sarietta/theoputer-blog/static/img/the-first-operation/4x/step1@4x.png

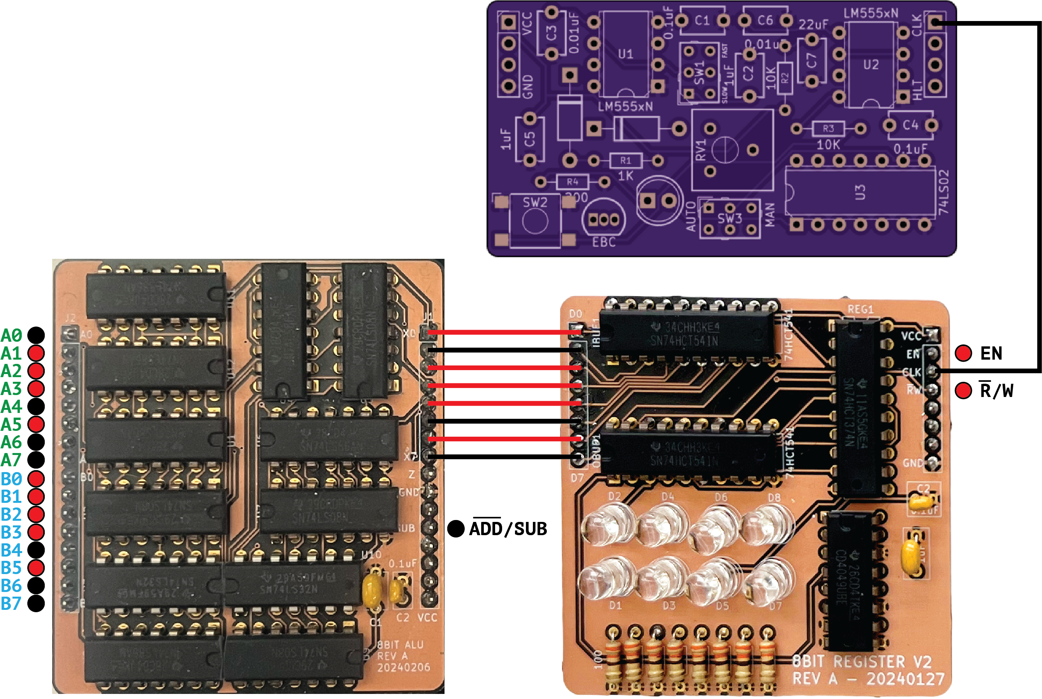
static/img/the-first-operation/4x/step1@4x.png
