sarietta/theoputer-blog/static/img/overview/programmer.png

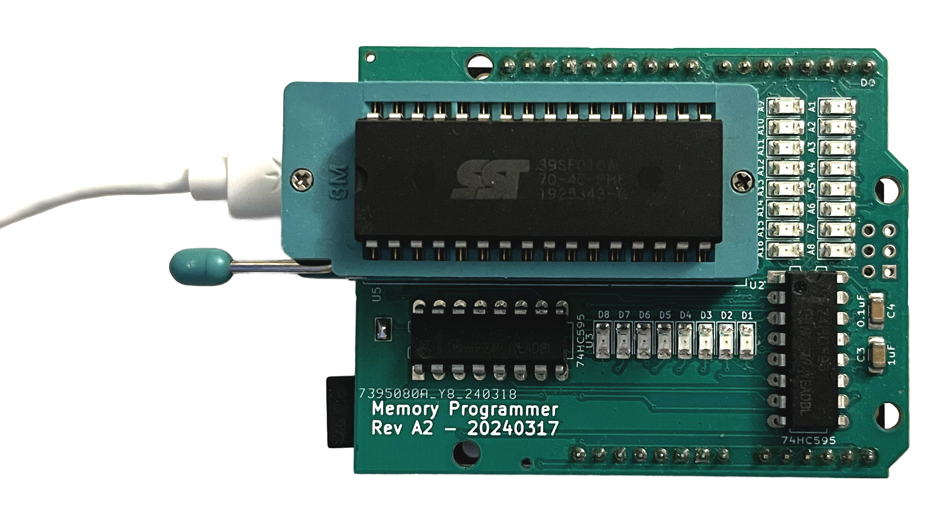
static/img/overview/programmer.png
