sarietta/theoputer-blog/static/img/1x/clock-cycle.png

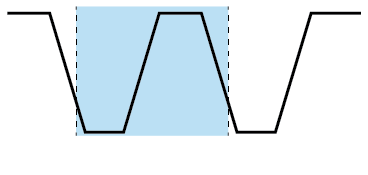
static/img/1x/clock-cycle.png
