sarietta/theoputer-blog/static/img/1x/do-irq-set.png

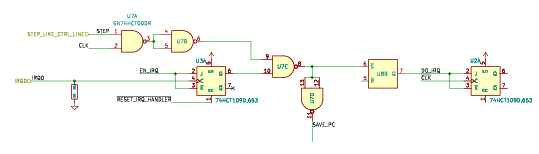
static/img/1x/do-irq-set.png
