sarietta/theoputer-blog/static/img/1x/down-clock-phase.png

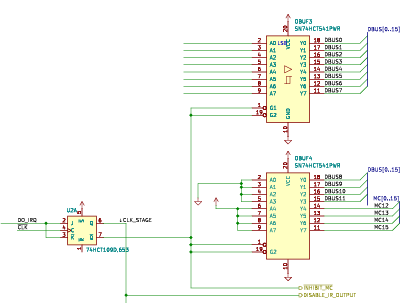
static/img/1x/down-clock-phase.png
