sarietta/theoputer-blog/static/img/1x/load-irq-address.png

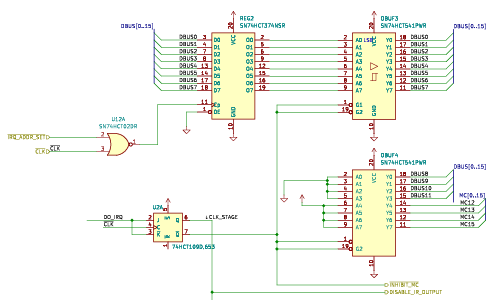
static/img/1x/load-irq-address.png
