sarietta/theoputer-blog/static/img/1x/missed-interrupts.png

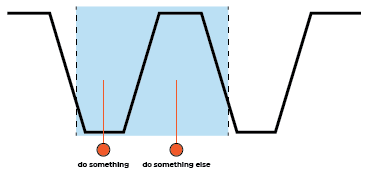
static/img/1x/missed-interrupts.png
