sarietta/theoputer-blog/static/img/1x/pc-address-return.png

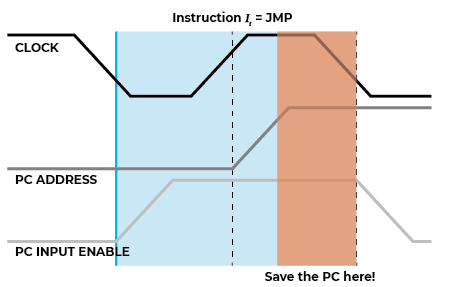
static/img/1x/pc-address-return.png
