sarietta/theoputer-blog/static/img/1x/return-to-normal-execution.png

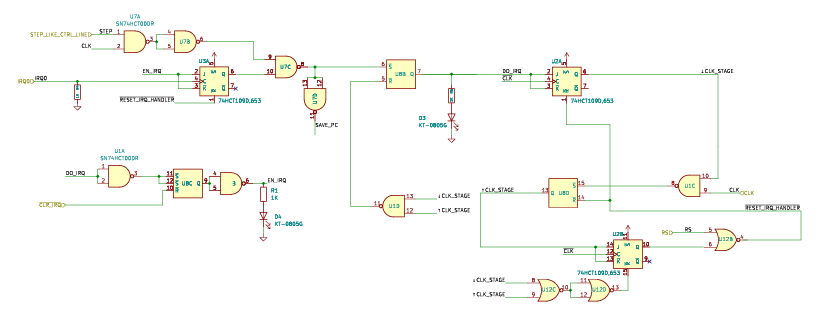
static/img/1x/return-to-normal-execution.png
