sarietta/theoputer-blog/static/img/8bit-register.png

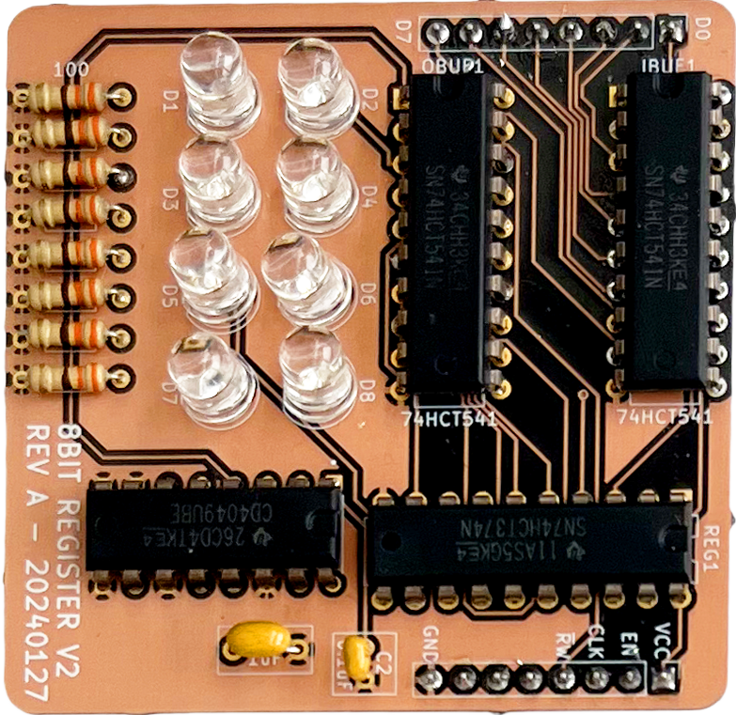
static/img/8bit-register.png
