sarietta/theoputer-blog/static/img/alu/alu-final-stage.png

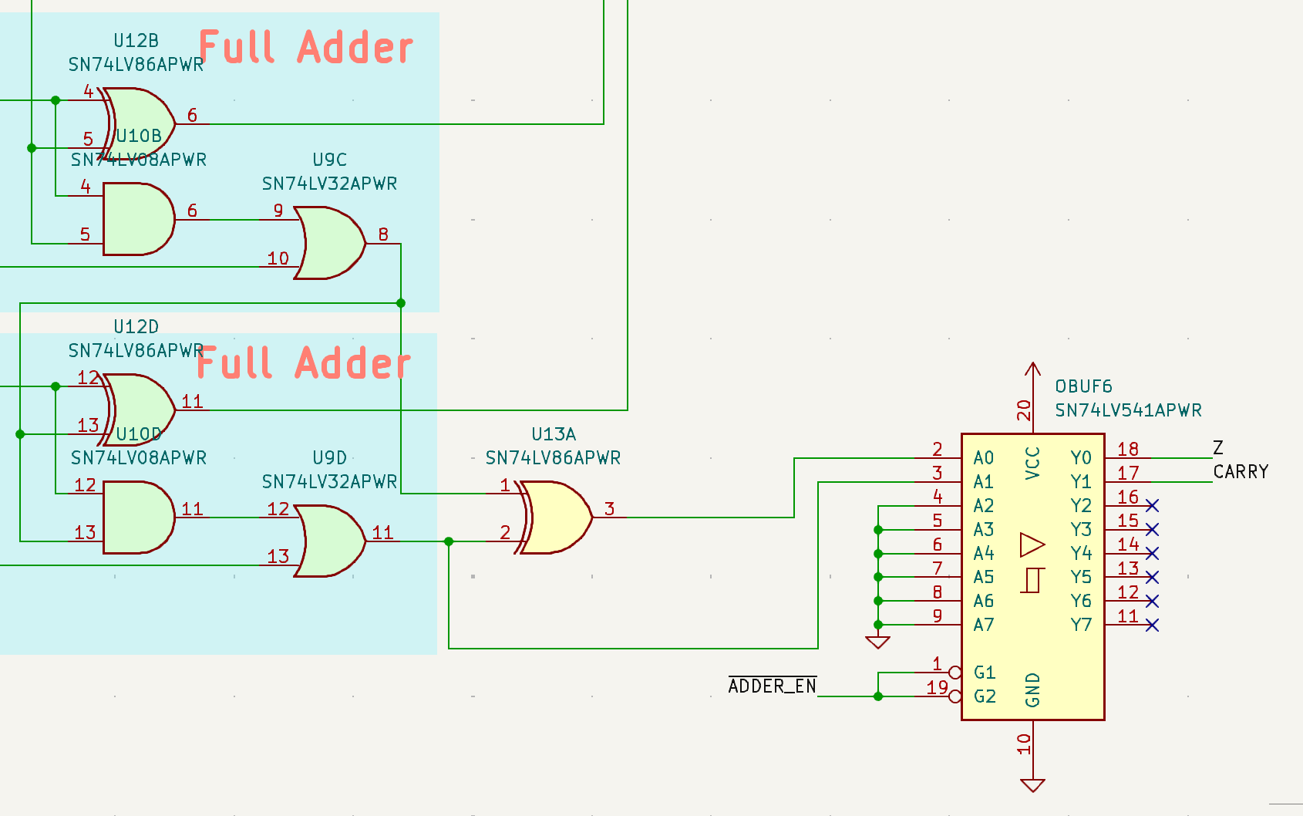
static/img/alu/alu-final-stage.png
