sarietta/theoputer-blog/static/img/alu/alu-interface.png

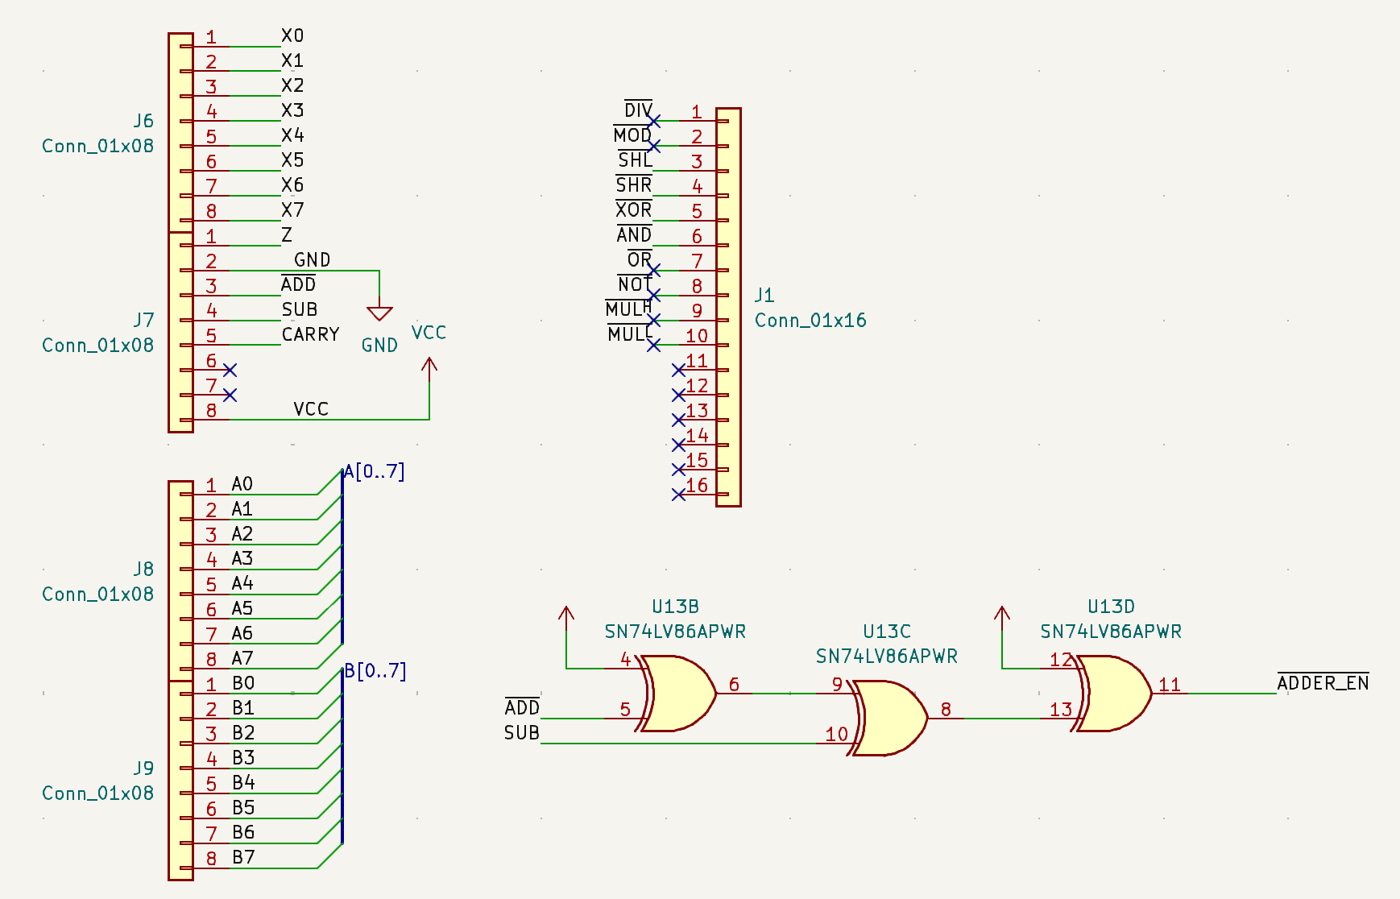
static/img/alu/alu-interface.png
