sarietta/theoputer-blog/static/img/alu/alu-subtraction.png

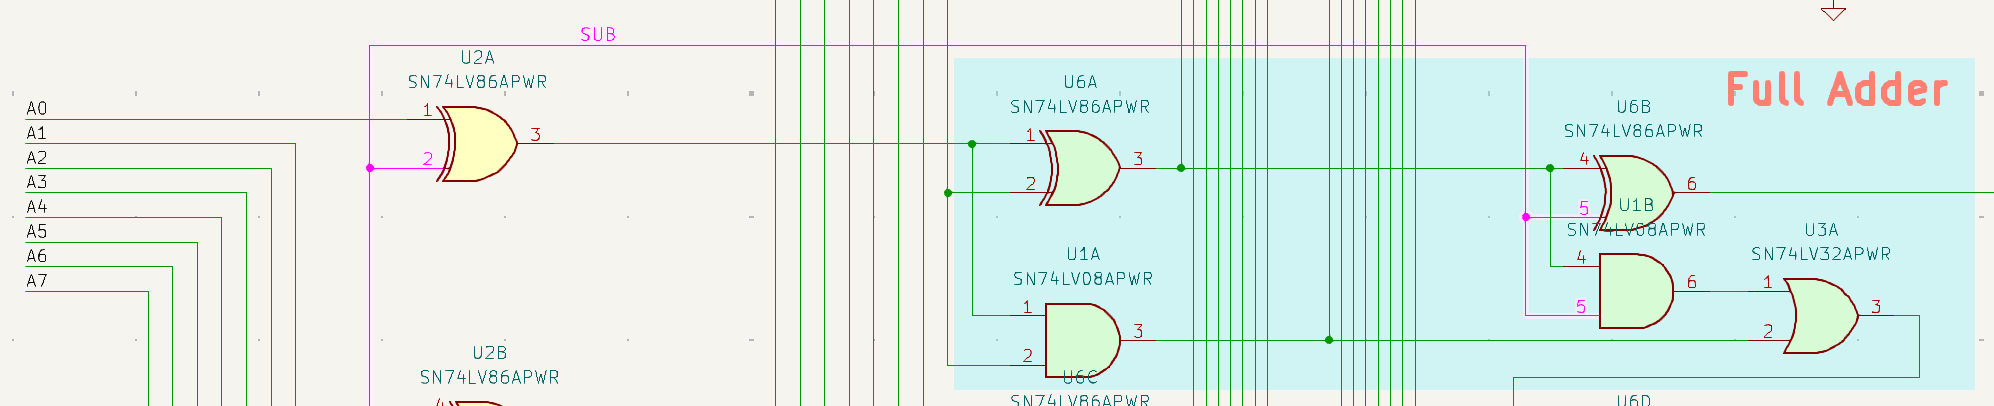
static/img/alu/alu-subtraction.png
