sarietta/theoputer-blog/static/img/c-compiler-intro/4x/parsed@4x.png

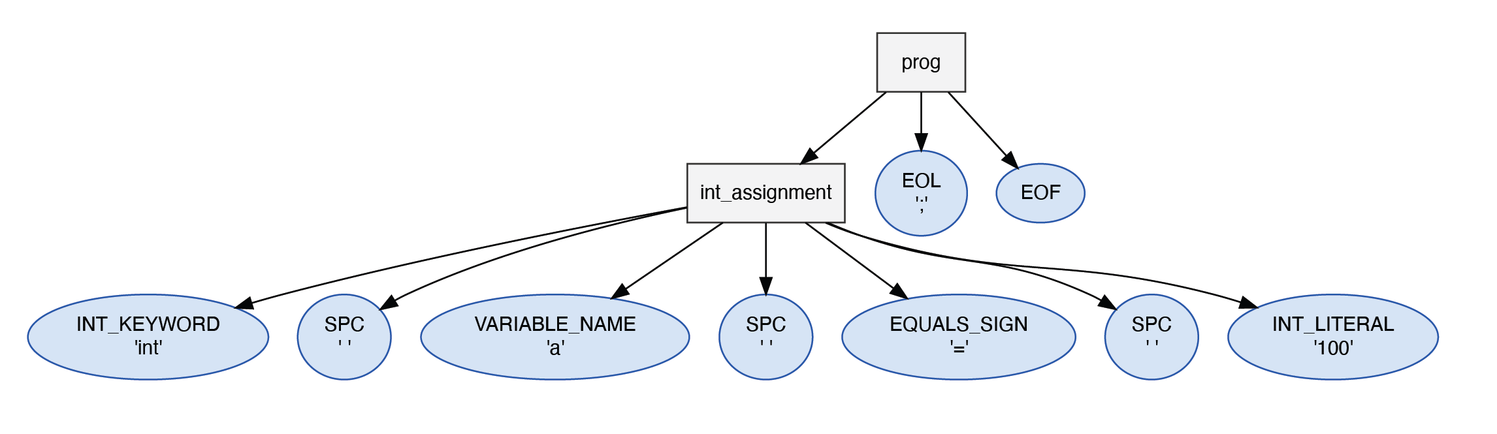
static/img/c-compiler-intro/4x/parsed@4x.png
