sarietta/theoputer-blog/static/img/CD74HCT161-delays.png

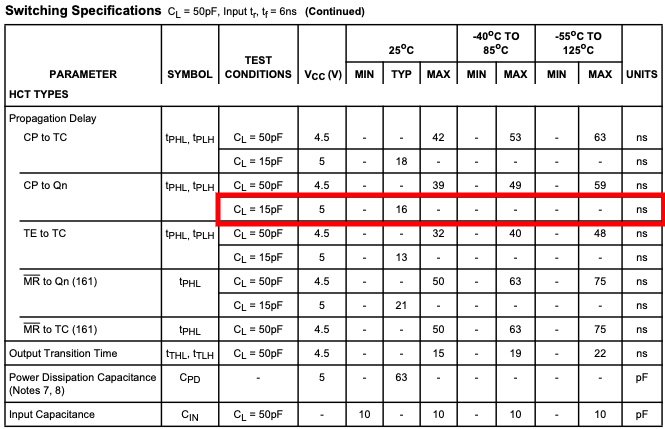
static/img/CD74HCT161-delays.png
