sarietta/theoputer-blog/static/img/clock-cycle.png

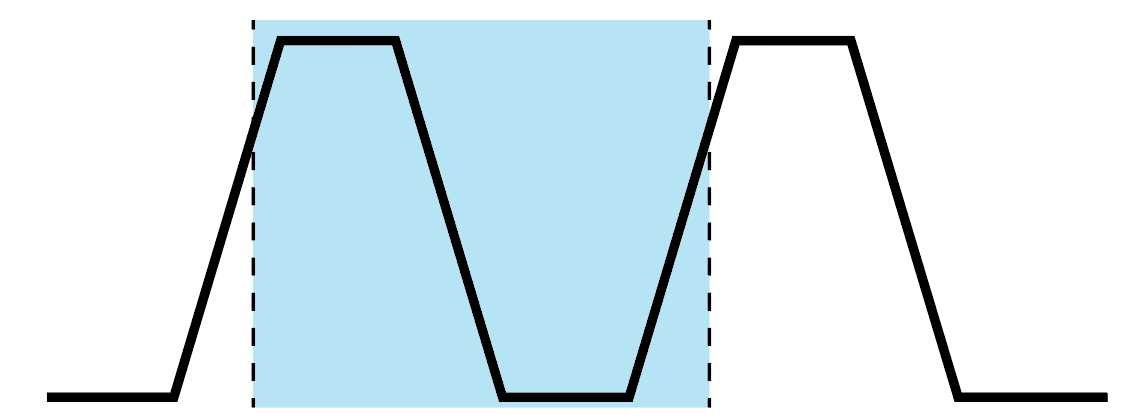
static/img/clock-cycle.png
