sarietta/theoputer-blog/static/img/clock-extras/debounce_bouncing.png

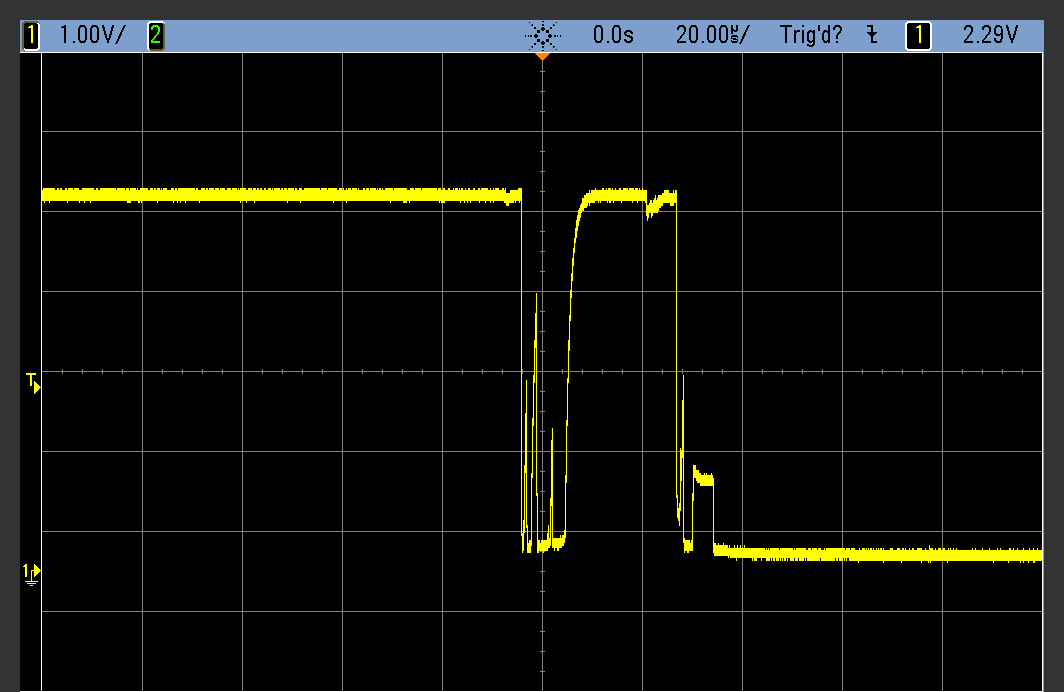
static/img/clock-extras/debounce_bouncing.png
