sarietta/theoputer-blog/static/img/clock-extras/monostable-multivibrator.png

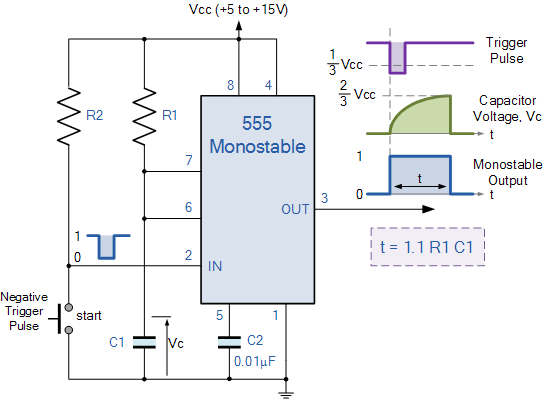
static/img/clock-extras/monostable-multivibrator.png
