sarietta/theoputer-blog/static/img/clock/2x/fetch-execute@2x.png

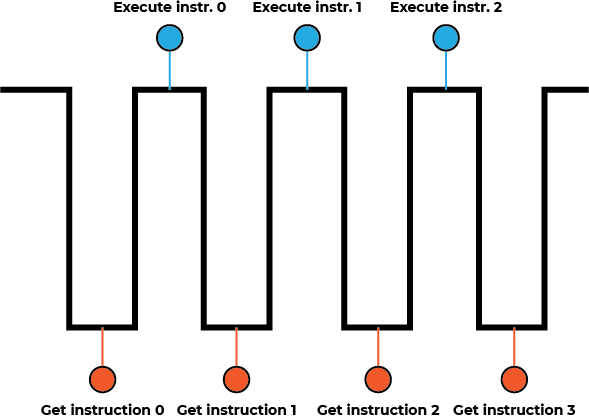
static/img/clock/2x/fetch-execute@2x.png
