sarietta/theoputer-blog/static/img/clock/2x/real-clock@2x.png

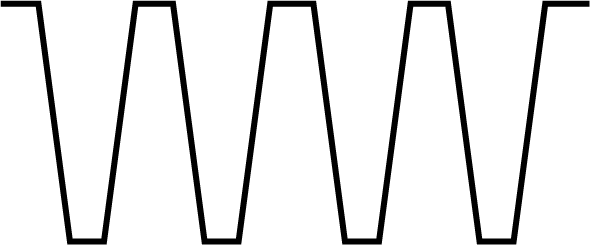
static/img/clock/2x/real-clock@2x.png
