sarietta/theoputer-blog/static/img/clock/2x/square-clock@2x.png

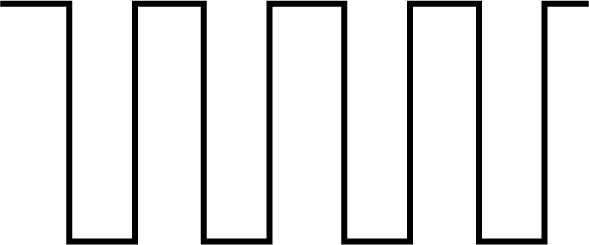
static/img/clock/2x/square-clock@2x.png
