sarietta/theoputer-blog/static/img/clock/4x/fetch-execute@4x.png

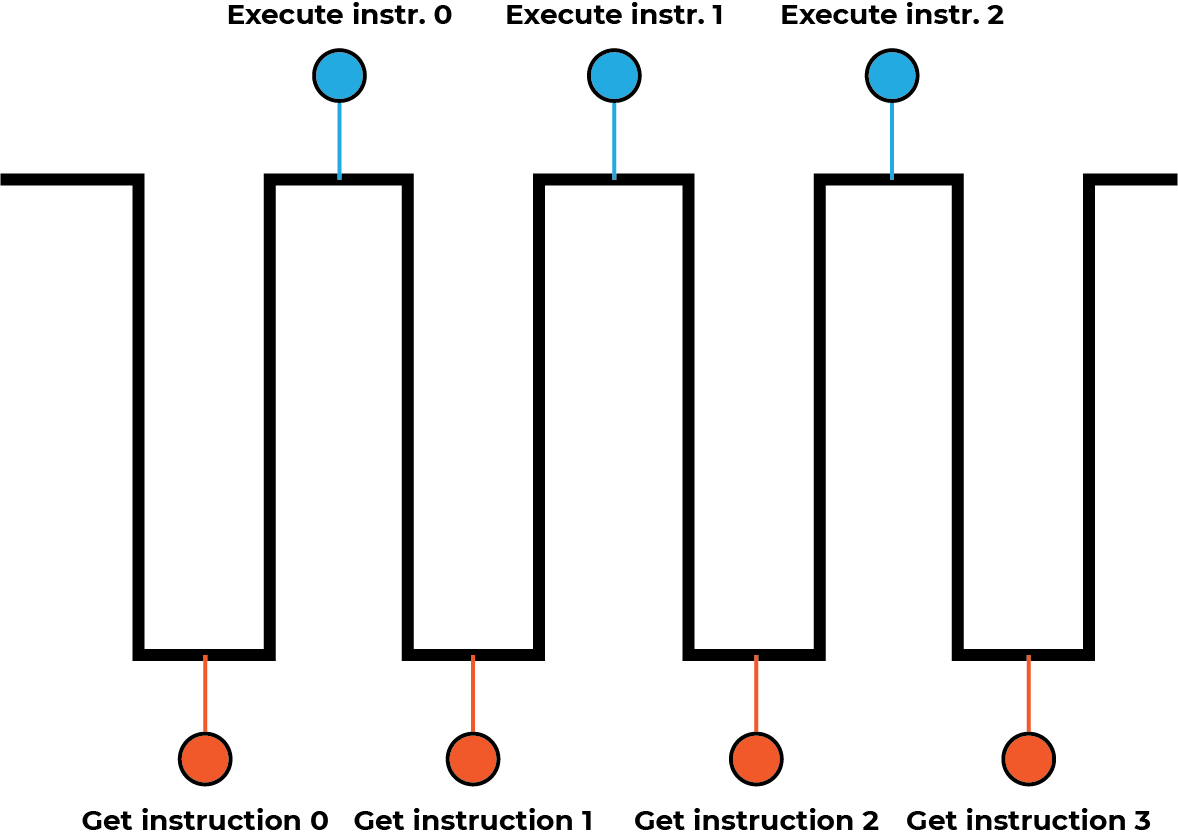
static/img/clock/4x/fetch-execute@4x.png
