sarietta/theoputer-blog/static/img/clock/4x/realistic-clock-cycle@4x.png

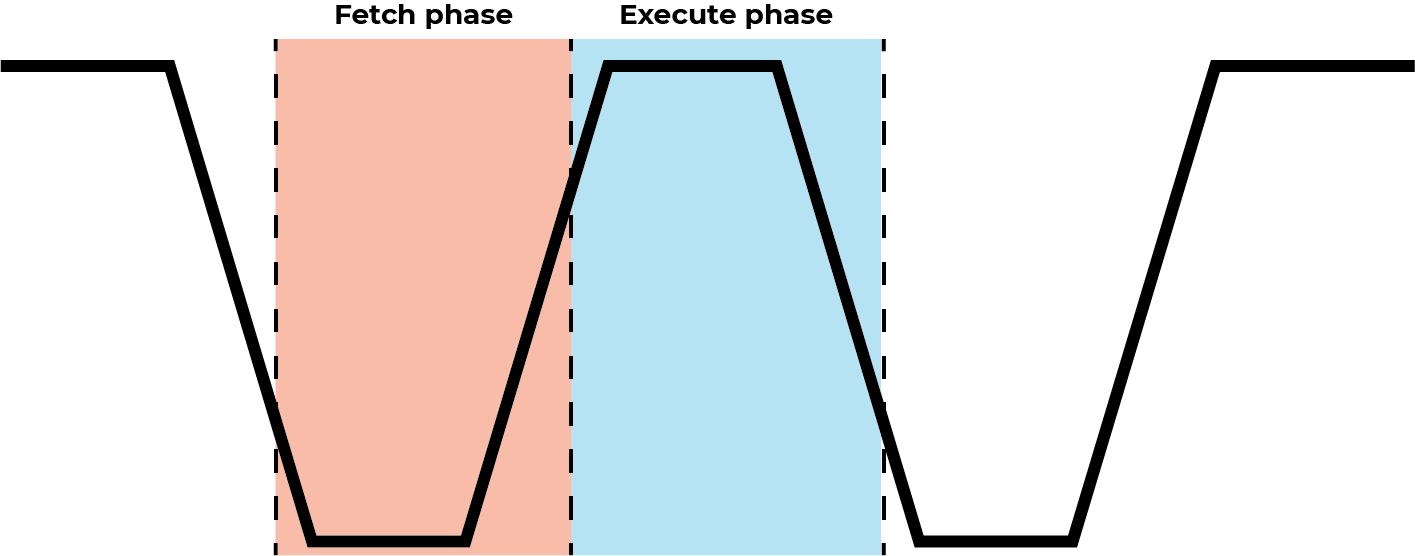
static/img/clock/4x/realistic-clock-cycle@4x.png
