sarietta/theoputer-blog/static/img/clock/4x/square-clock@4x.png

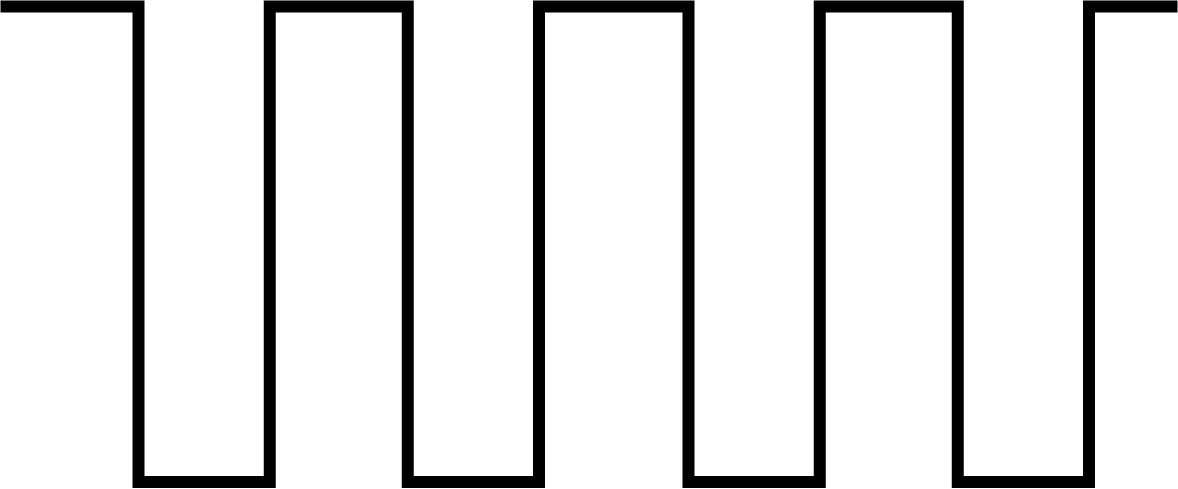
static/img/clock/4x/square-clock@4x.png
