sarietta/theoputer-blog/static/img/clock/Reciprocal-piezoelectric-effect-within-the-simplified-unit-cell-of-alpha-quartz-a.png

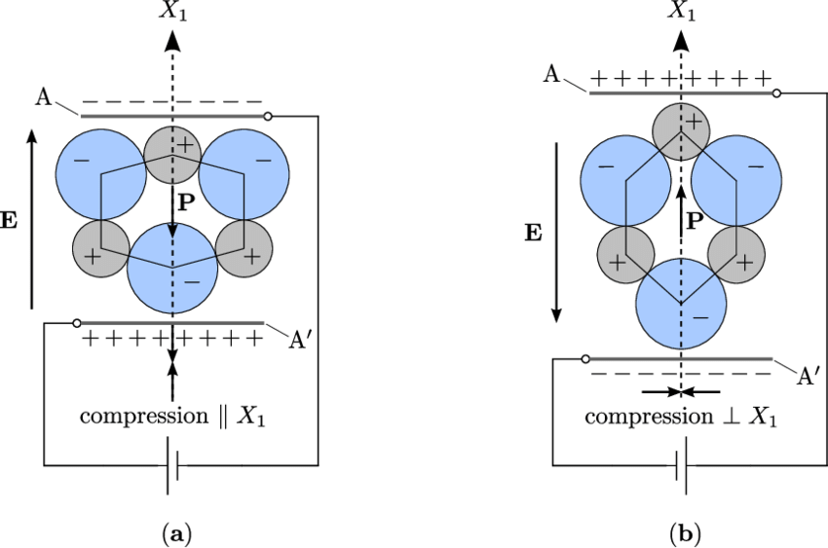
static/img/clock/Reciprocal-piezoelectric-effect-within-the-simplified-unit-cell-of-alpha-quartz-a.png
