sarietta/theoputer-blog/static/img/daughter-board/header.png

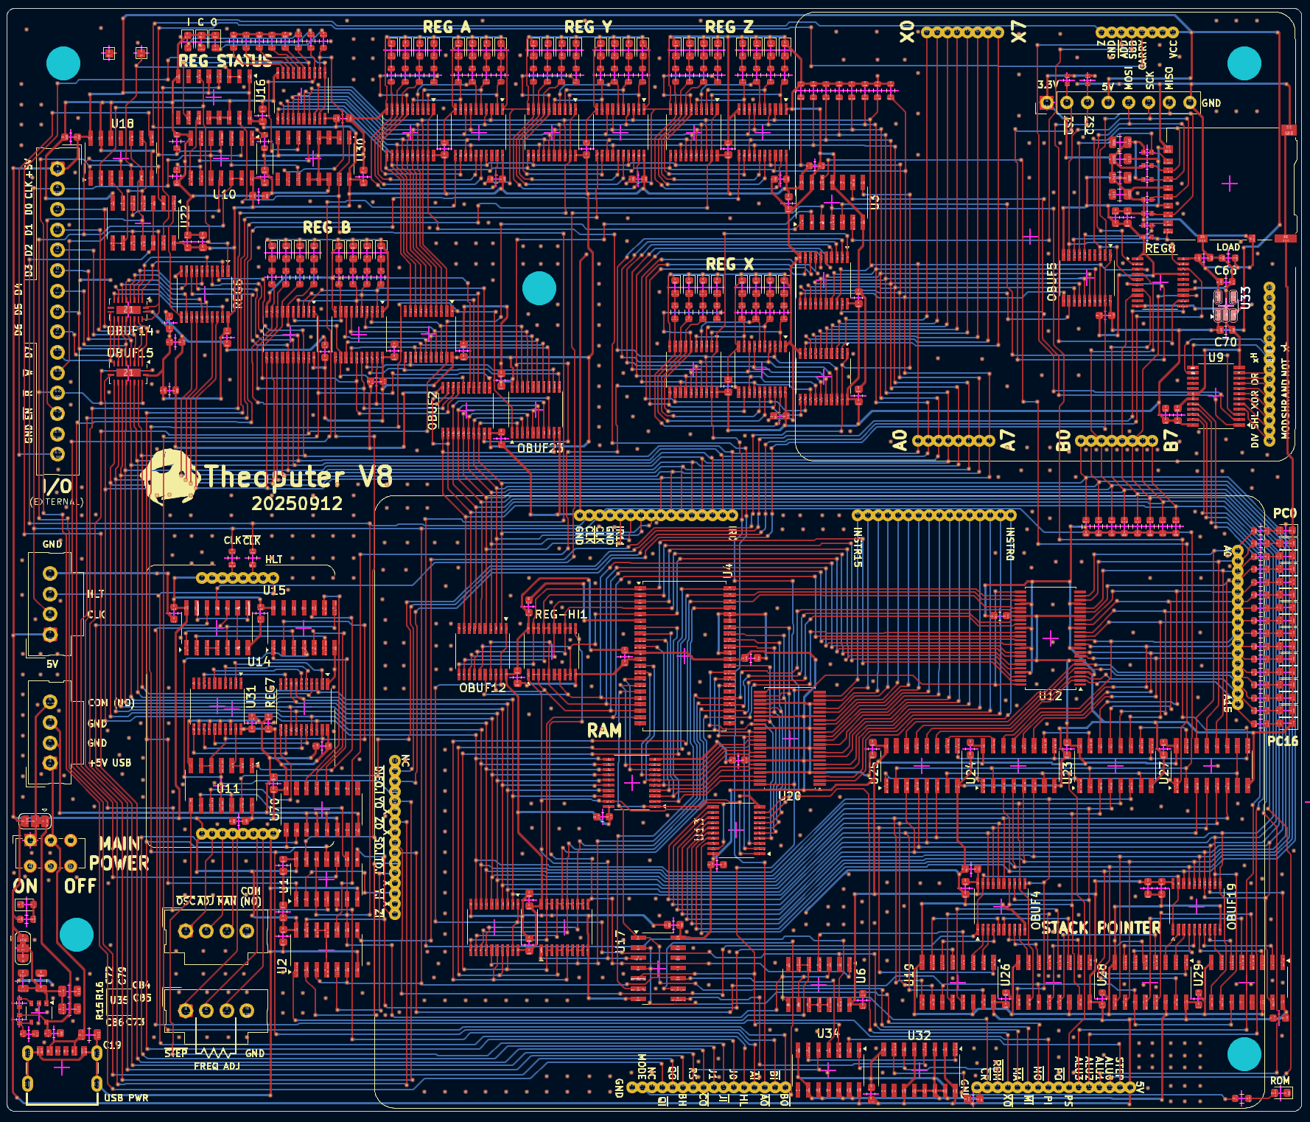
static/img/daughter-board/header.png
