sarietta/theoputer-blog/static/img/fourier-10-terms.png

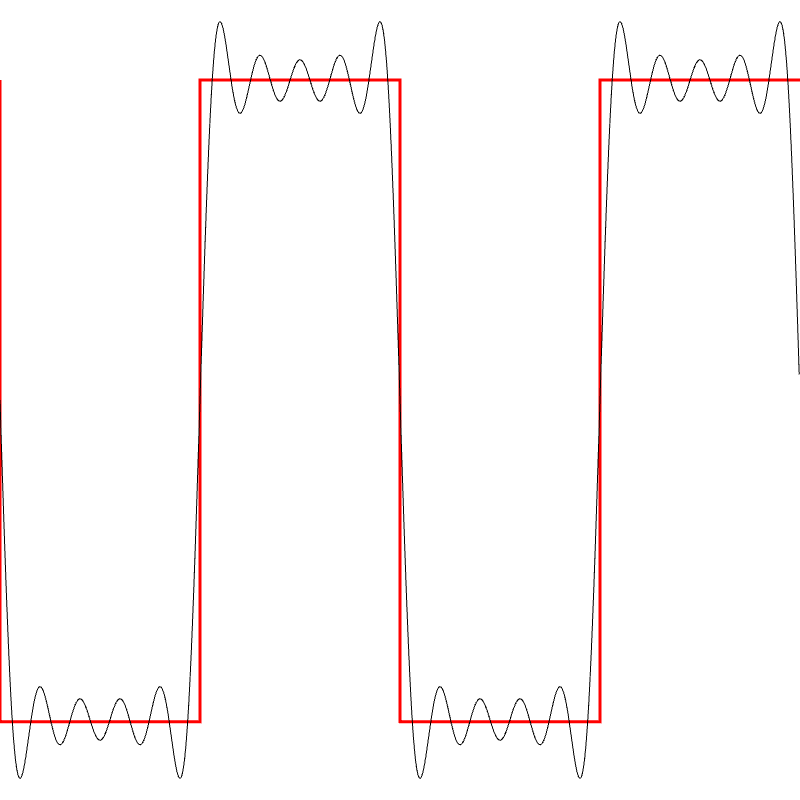
static/img/fourier-10-terms.png
