sarietta/theoputer-blog/static/img/ground-noise/header.png

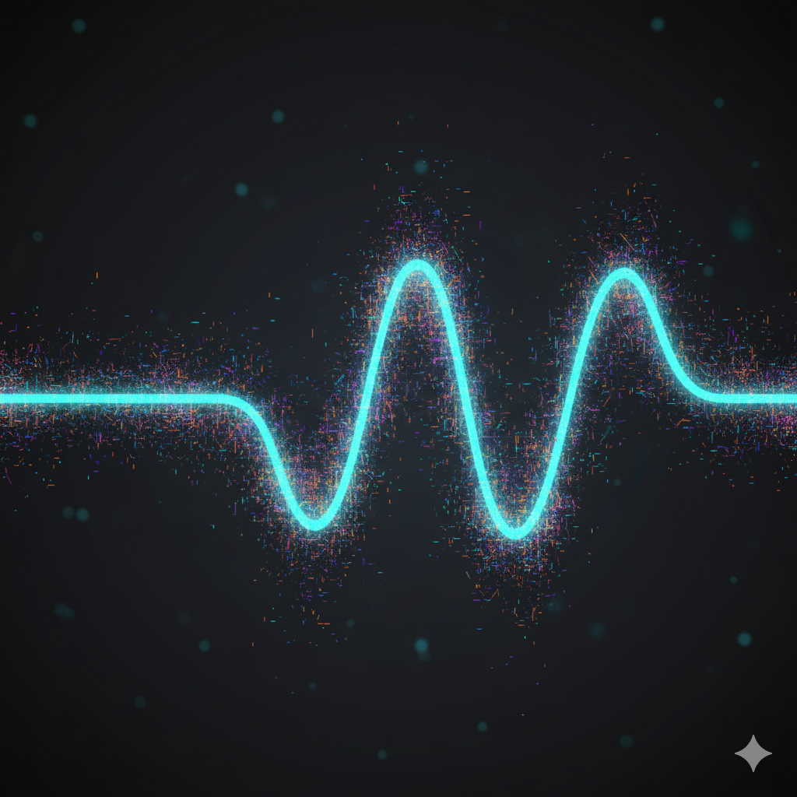
static/img/ground-noise/header.png
