sarietta/theoputer-blog/static/img/irq-mistake/2x/irq0-input-circtuit@2x.png

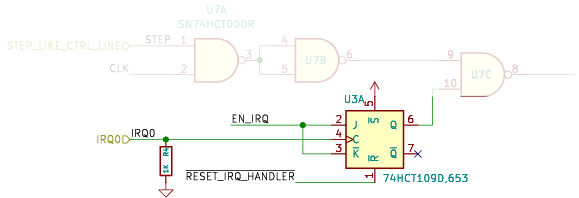
static/img/irq-mistake/2x/irq0-input-circtuit@2x.png
