sarietta/theoputer-blog/static/img/irq-mistake/2x/jk-flip-flop@2x.png

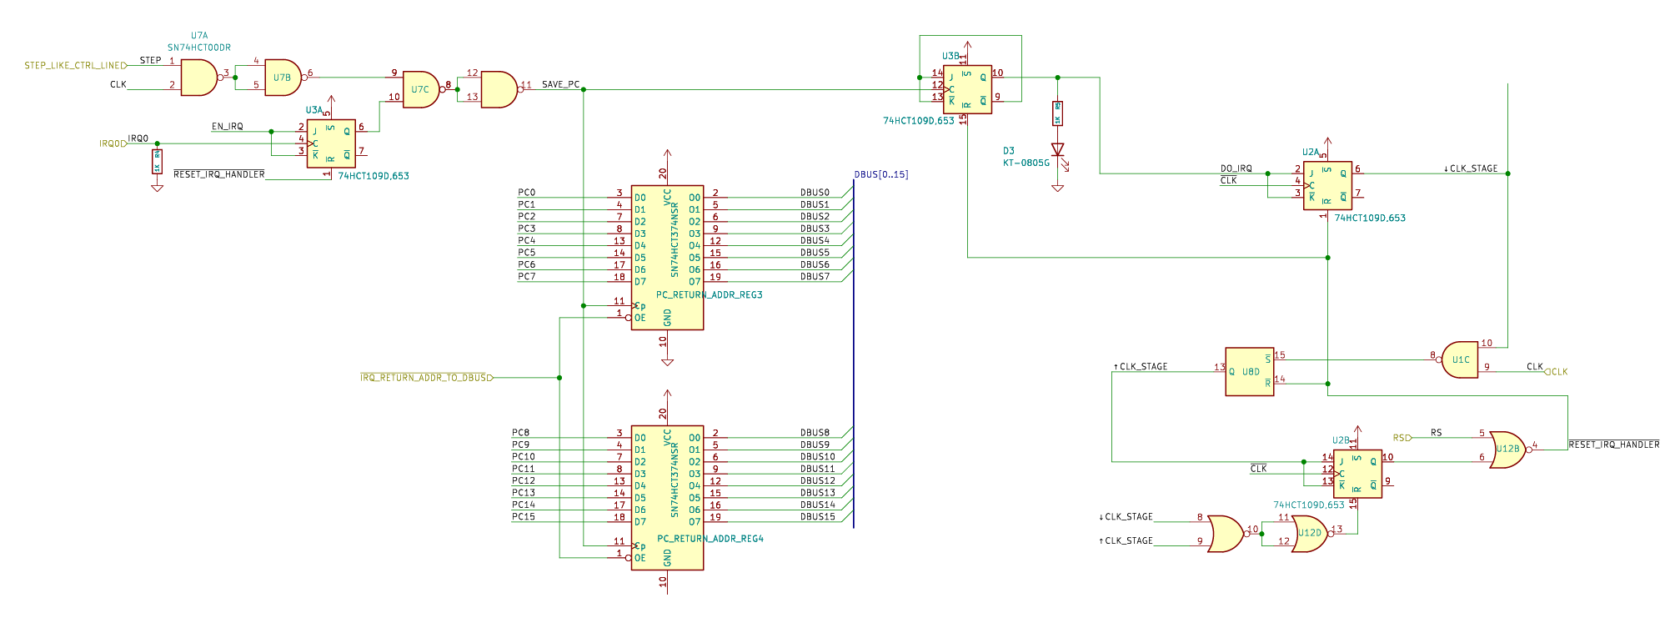
static/img/irq-mistake/2x/jk-flip-flop@2x.png
