sarietta/theoputer-blog/static/img/irq-mistake/2x/sr-latch@2x.png

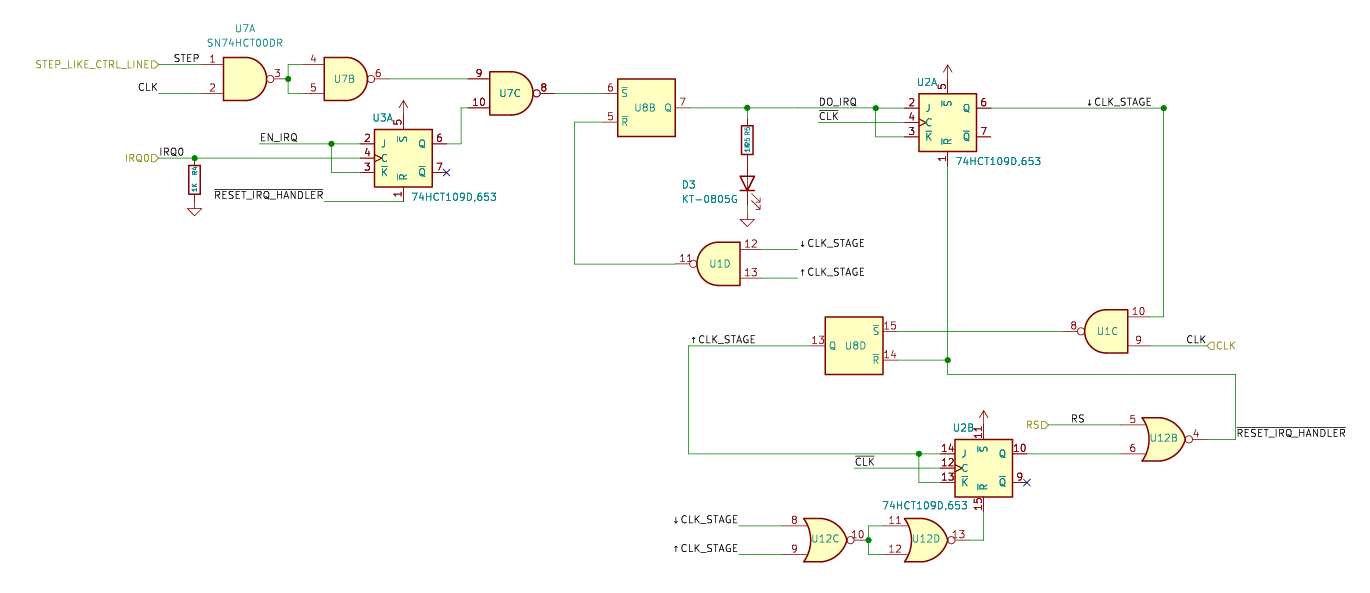
static/img/irq-mistake/2x/sr-latch@2x.png
