sarietta/theoputer-blog/static/img/irq-mistake/2x/timing-diagram-1@2x.png

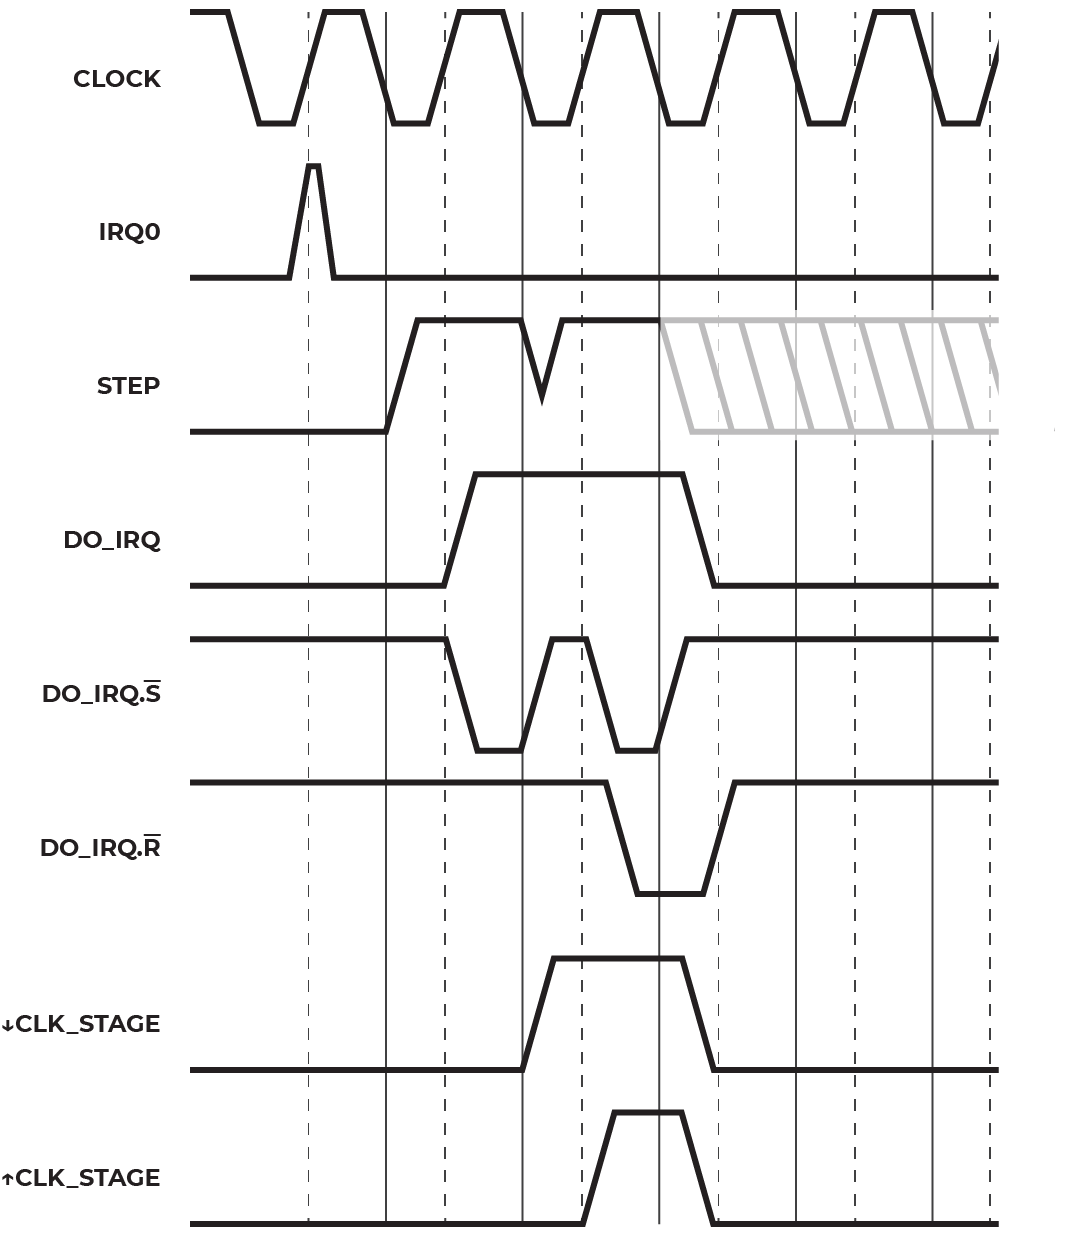
static/img/irq-mistake/2x/timing-diagram-1@2x.png
