sarietta/theoputer-blog/static/img/irq-mistake/2x/timing-diagram-exaggerated@2x.png

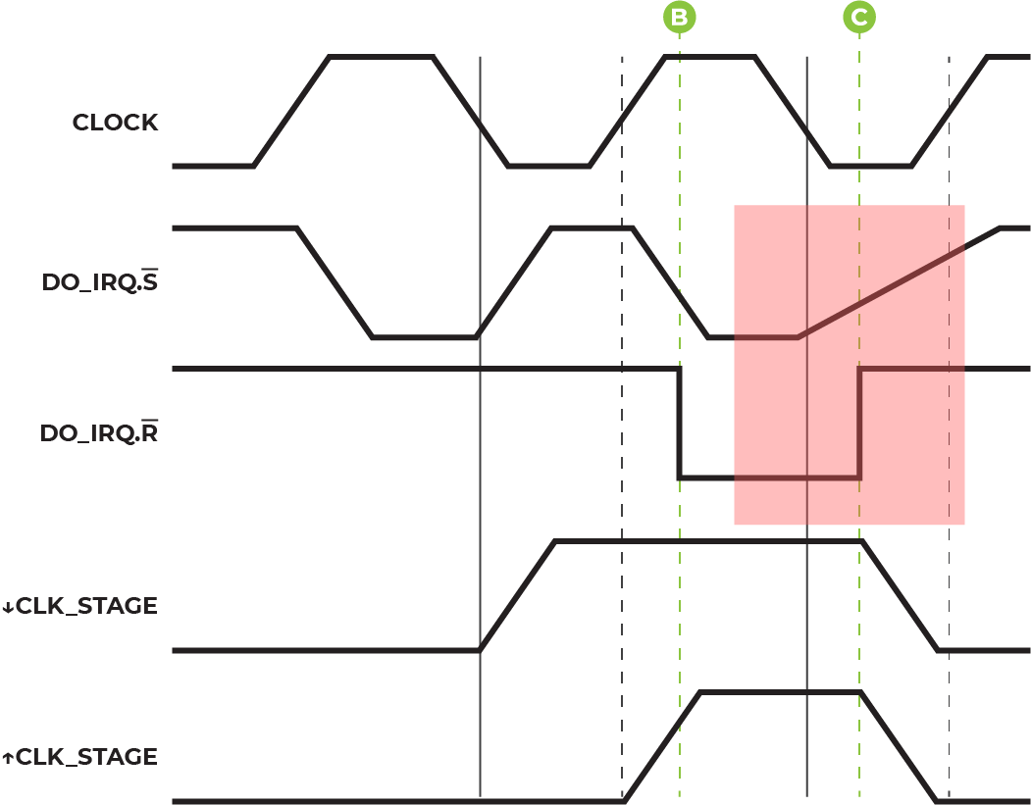
static/img/irq-mistake/2x/timing-diagram-exaggerated@2x.png
