sarietta/theoputer-blog/static/img/irq-mistake/2x/timing-diagram-simple@2x.png

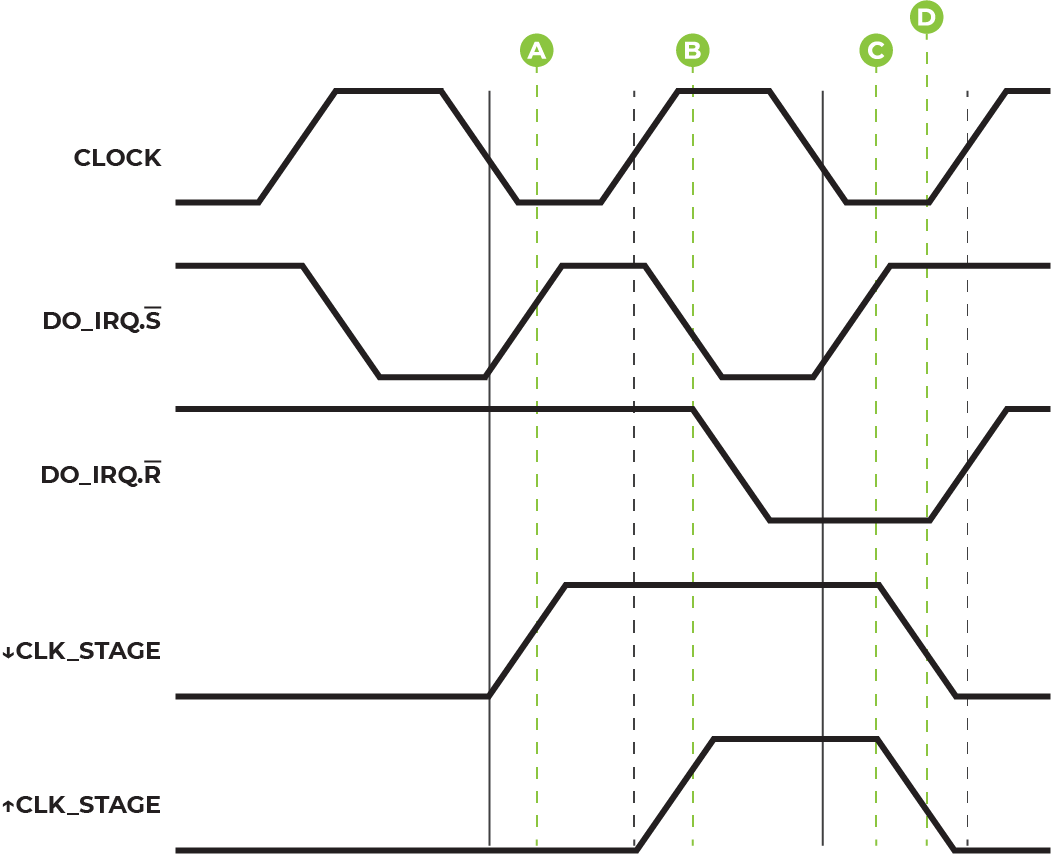
static/img/irq-mistake/2x/timing-diagram-simple@2x.png
