sarietta/theoputer-blog/static/img/irq-stage-3.png

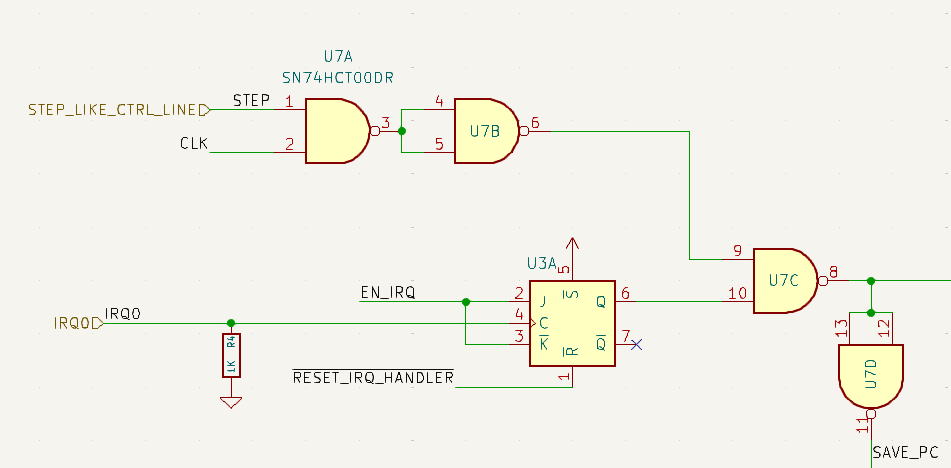
static/img/irq-stage-3.png
