sarietta/theoputer-blog/static/img/program-counter/4x/accurate@4x.png

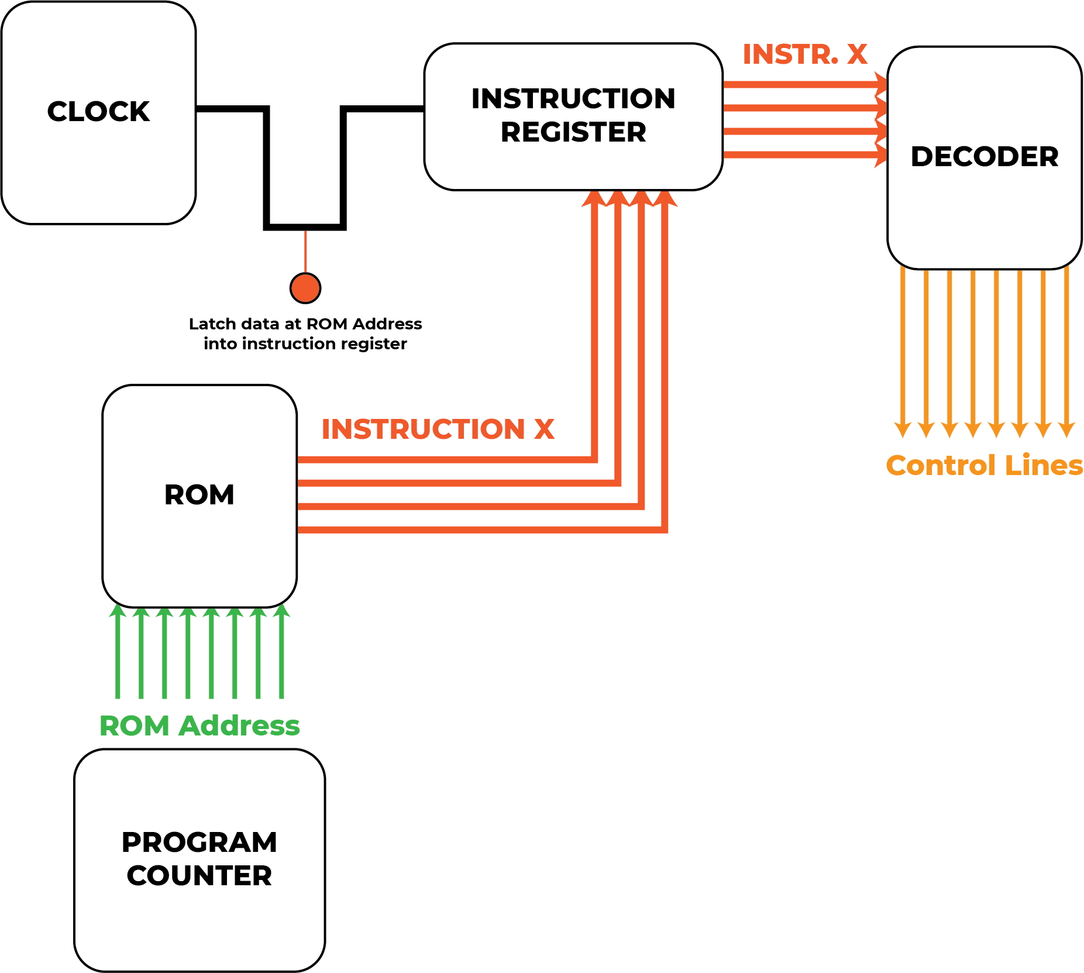
static/img/program-counter/4x/accurate@4x.png
