sarietta/theoputer-blog/static/img/program-counter/4x/idealized@4x.png

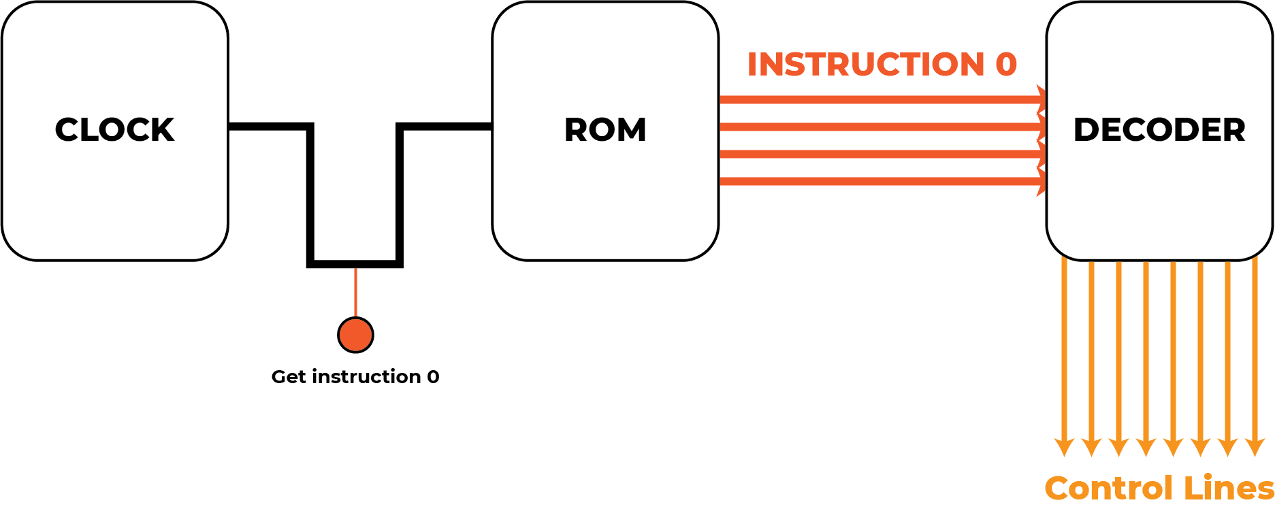
static/img/program-counter/4x/idealized@4x.png
