sarietta/theoputer-blog/static/img/program-counter/4x/program-counter@4x.png

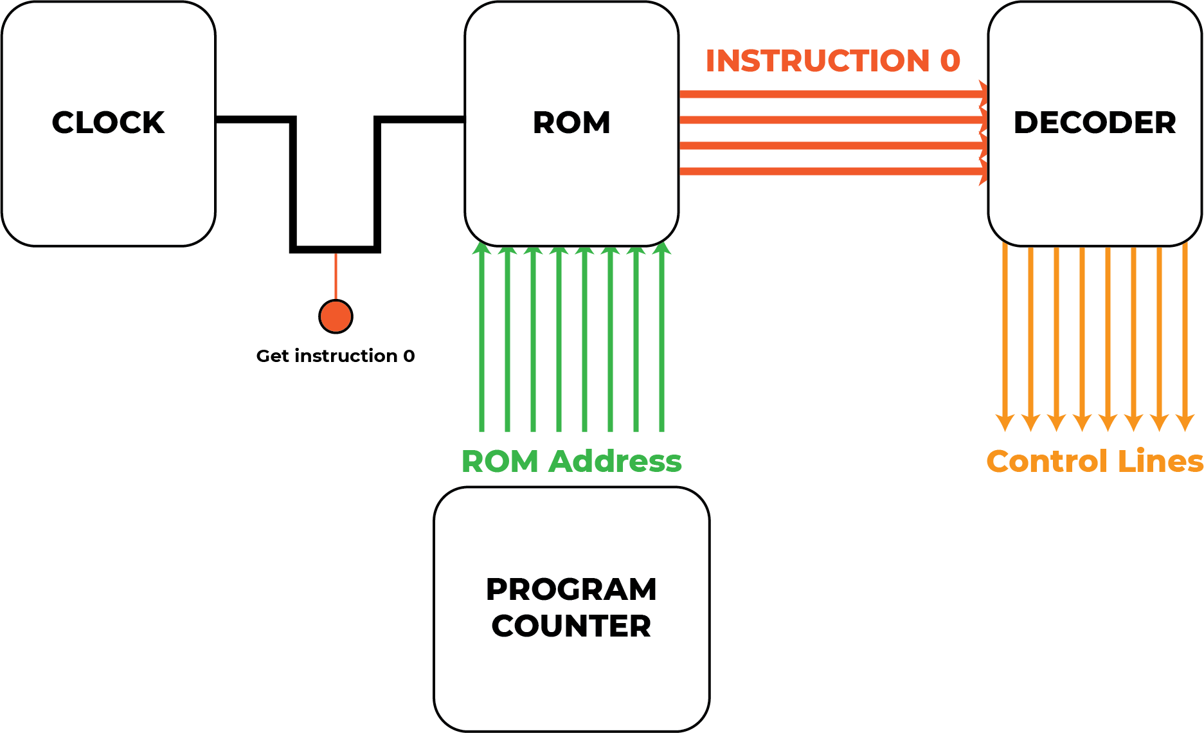
static/img/program-counter/4x/program-counter@4x.png
