sarietta/theoputer-blog/static/img/ram/header.png

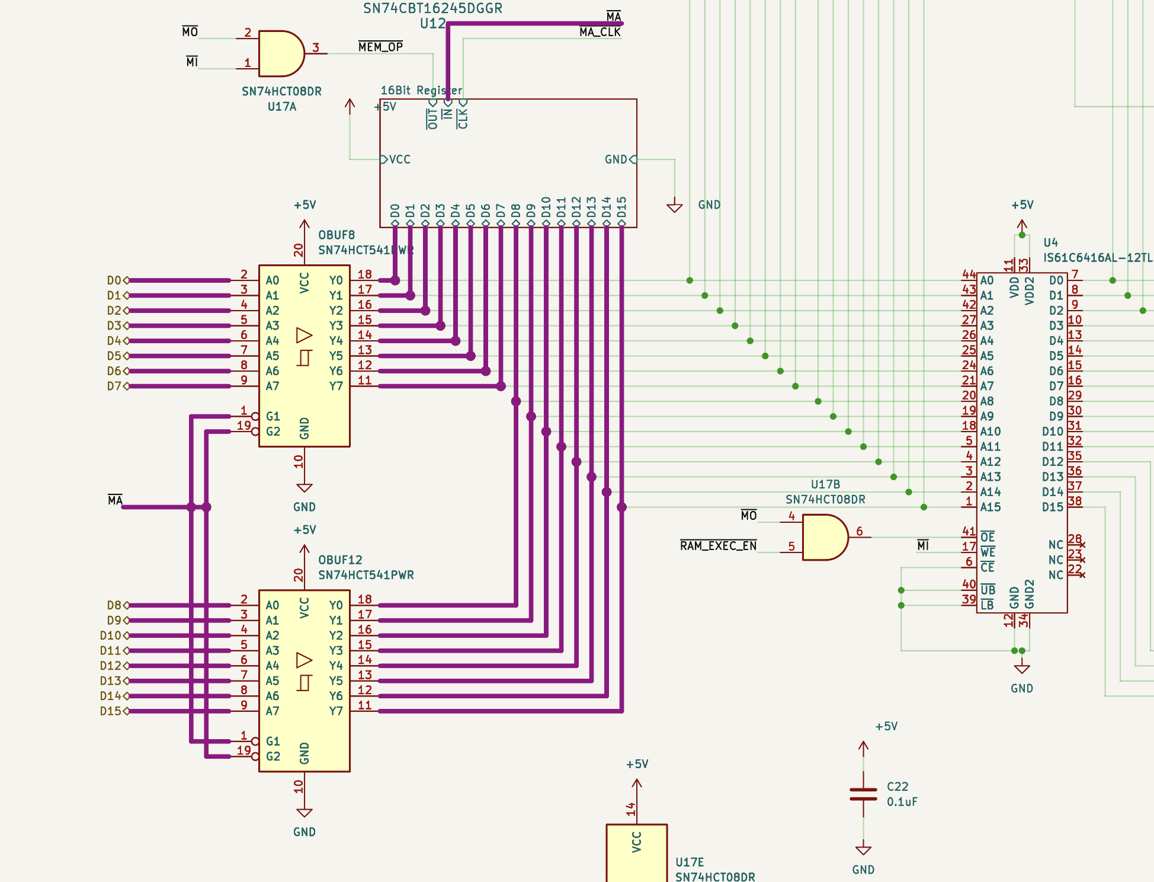
static/img/ram/header.png
