sarietta/theoputer-blog/static/img/recursion/4x/function-call@4x.png

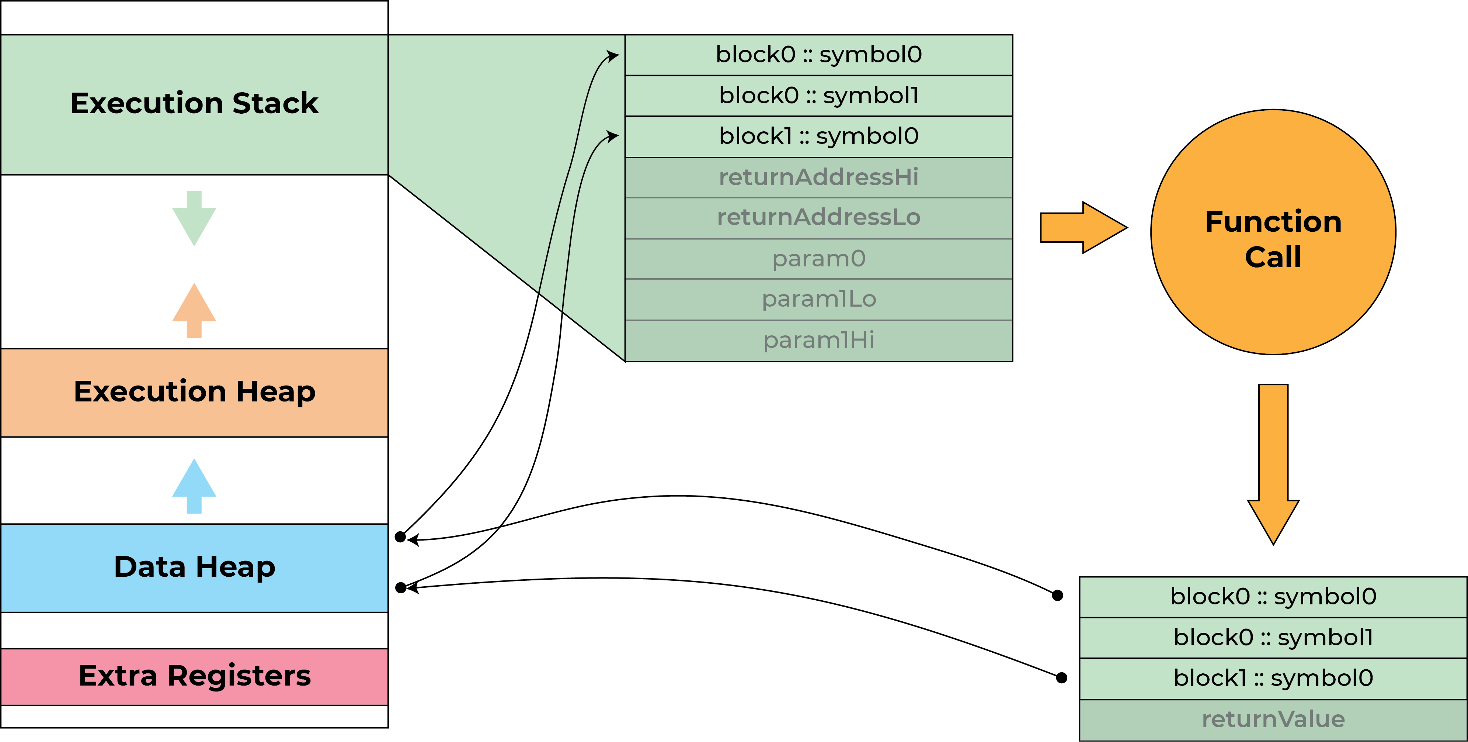
static/img/recursion/4x/function-call@4x.png
