sarietta/theoputer-blog/static/img/recursion/4x/memory-layout@4x.png

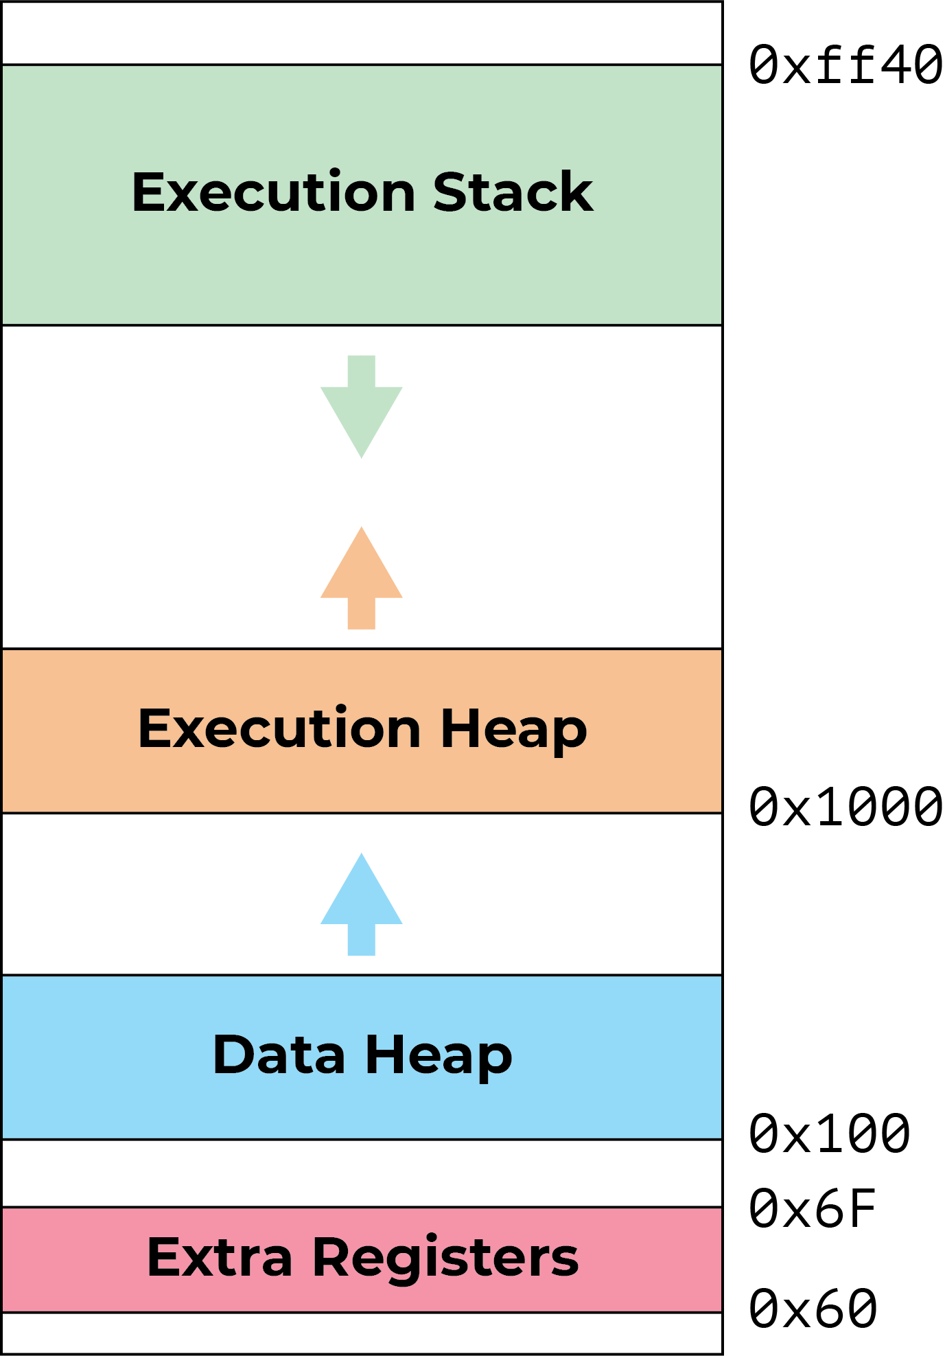
static/img/recursion/4x/memory-layout@4x.png
