sarietta/theoputer-blog/static/img/registers/8bit-register-v3.png

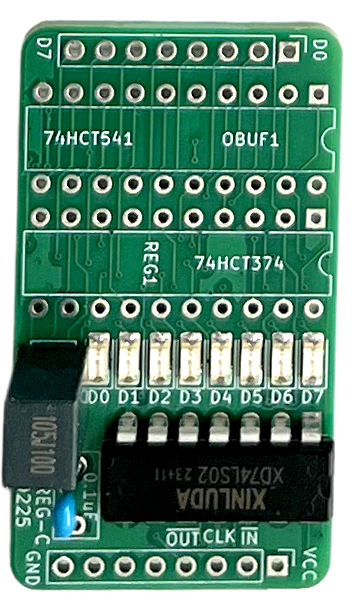
static/img/registers/8bit-register-v3.png
