sarietta/theoputer-blog/static/img/registers/8bit-register.png

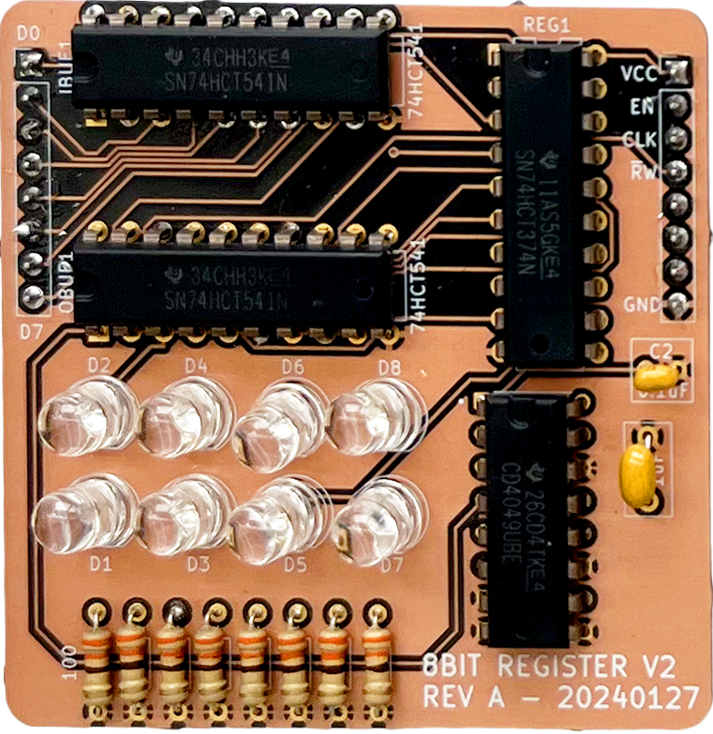
static/img/registers/8bit-register.png
