sarietta/theoputer-blog/static/img/registers/16bit-register-v3.png

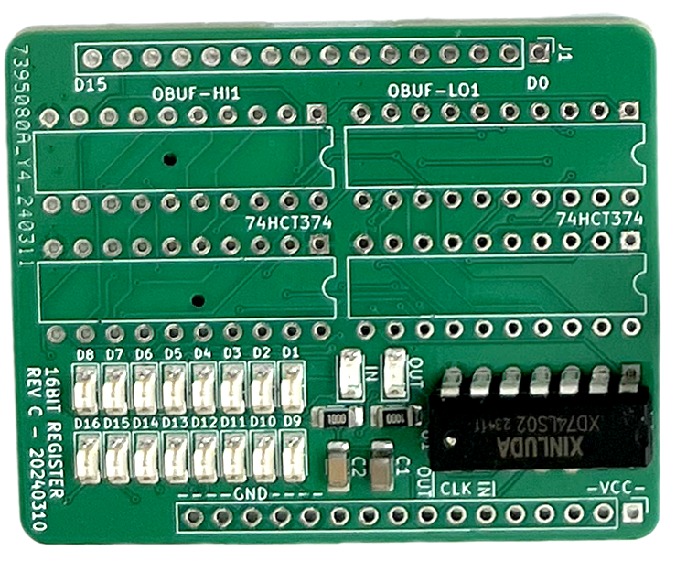
static/img/registers/16bit-register-v3.png
