sarietta/theoputer-blog/static/img/registers/16bit-register.png

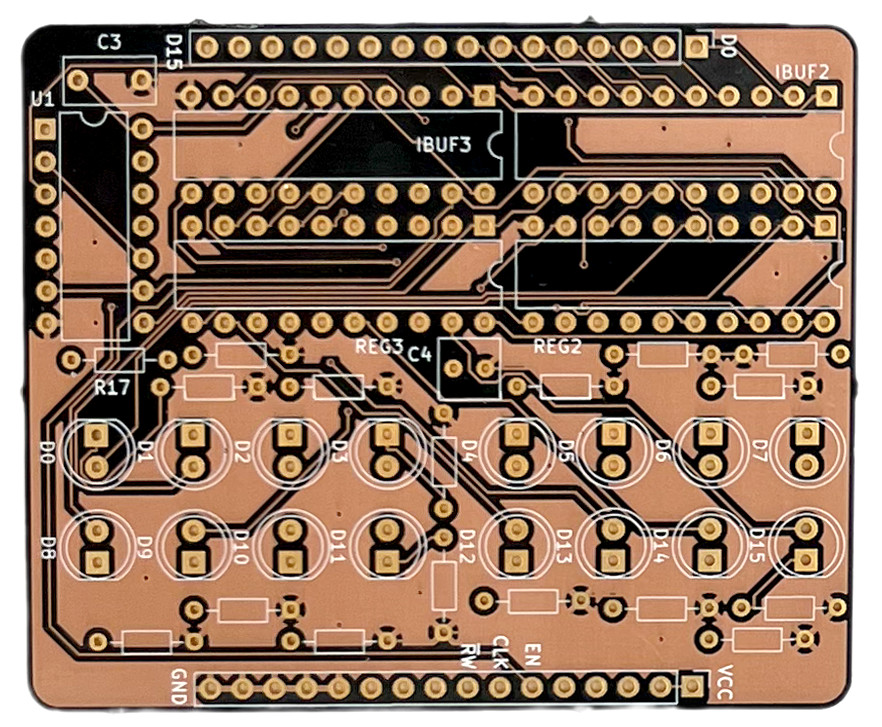
static/img/registers/16bit-register.png
