sarietta/theoputer-blog/static/img/Screenshot 2024-10-08 at 2.37.41 PM.png

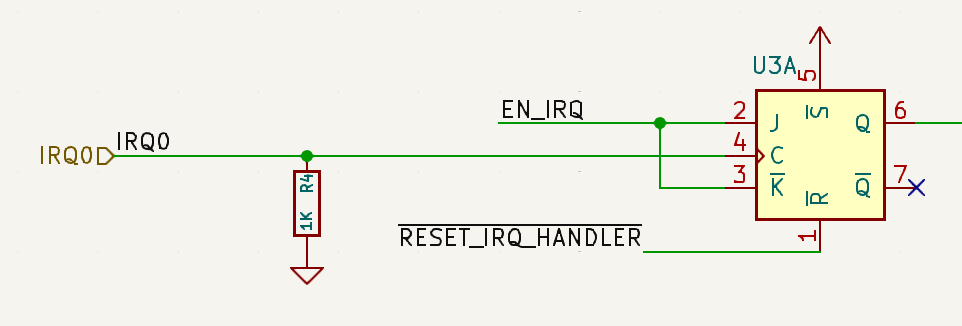
static/img/Screenshot 2024-10-08 at 2.37.41 PM.png
