sarietta/theoputer-blog/static/img/Screenshot 2024-10-08 at 3.12.51 PM.png

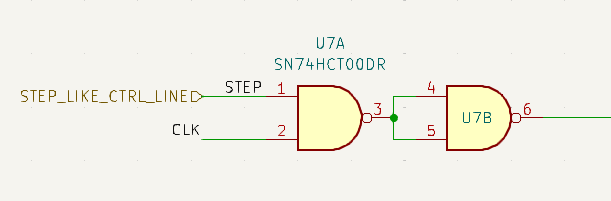
static/img/Screenshot 2024-10-08 at 3.12.51 PM.png
