sarietta/theoputer-blog/static/img/Screenshot 2024-10-08 at 3.57.22 PM.png

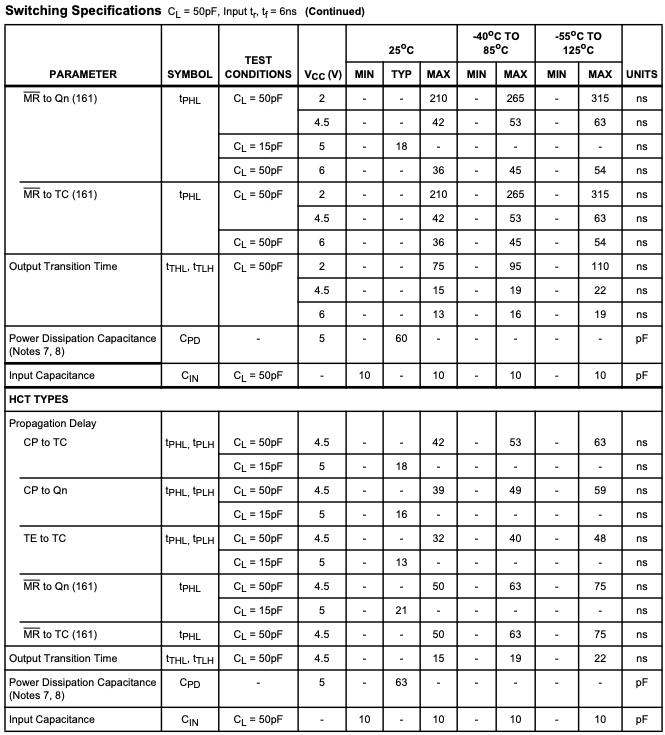
static/img/Screenshot 2024-10-08 at 3.57.22 PM.png
