sarietta/theoputer-blog/static/img/Screenshot 2024-10-08 at 4.09.38 PM.png

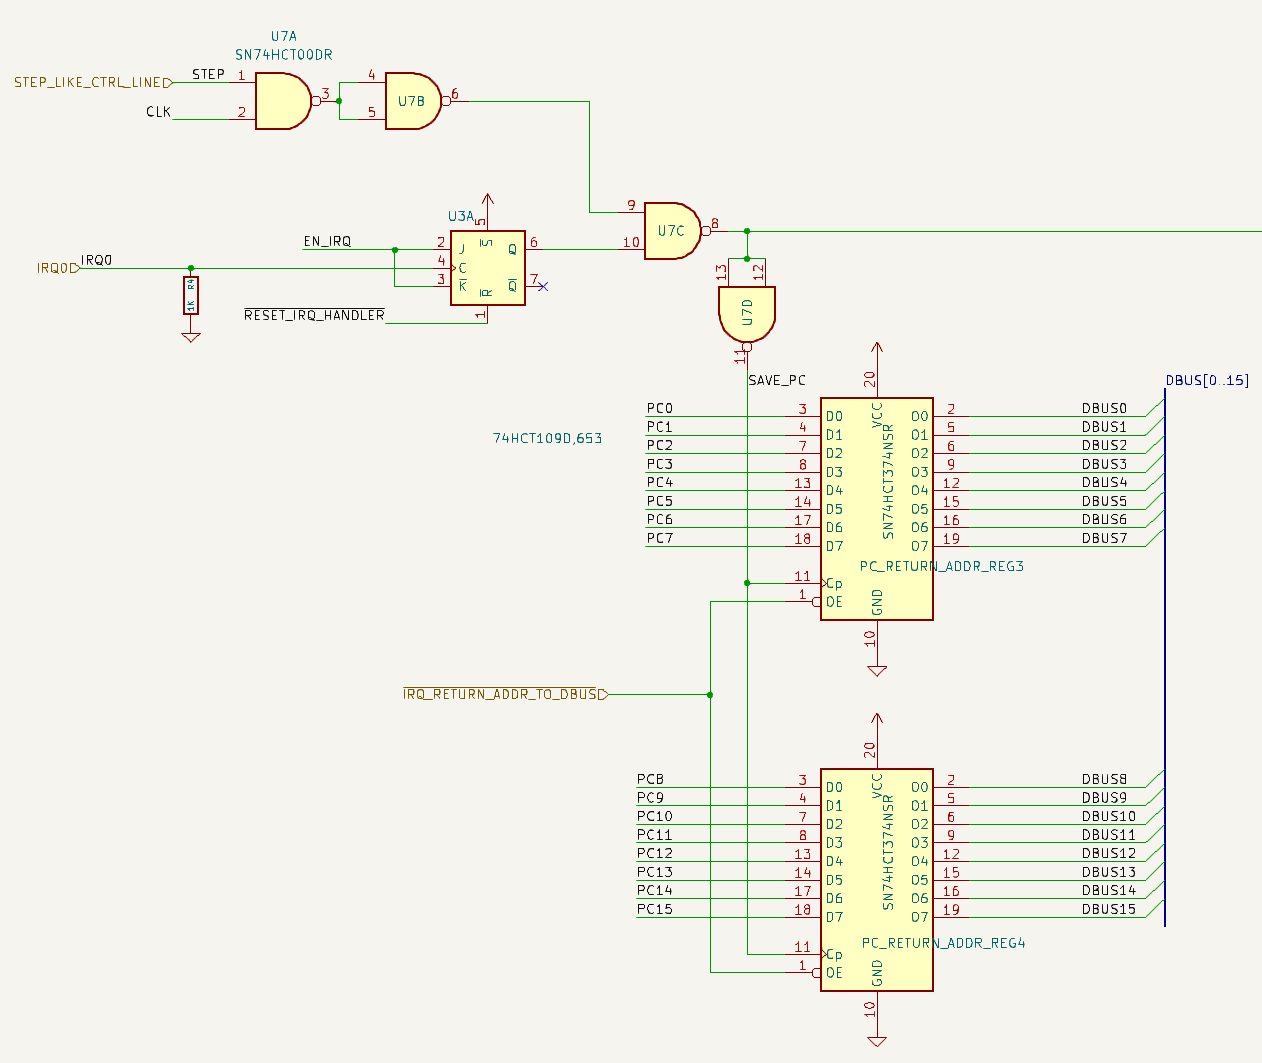
static/img/Screenshot 2024-10-08 at 4.09.38 PM.png
