sarietta/theoputer-blog/static/img/simulator/header.gif

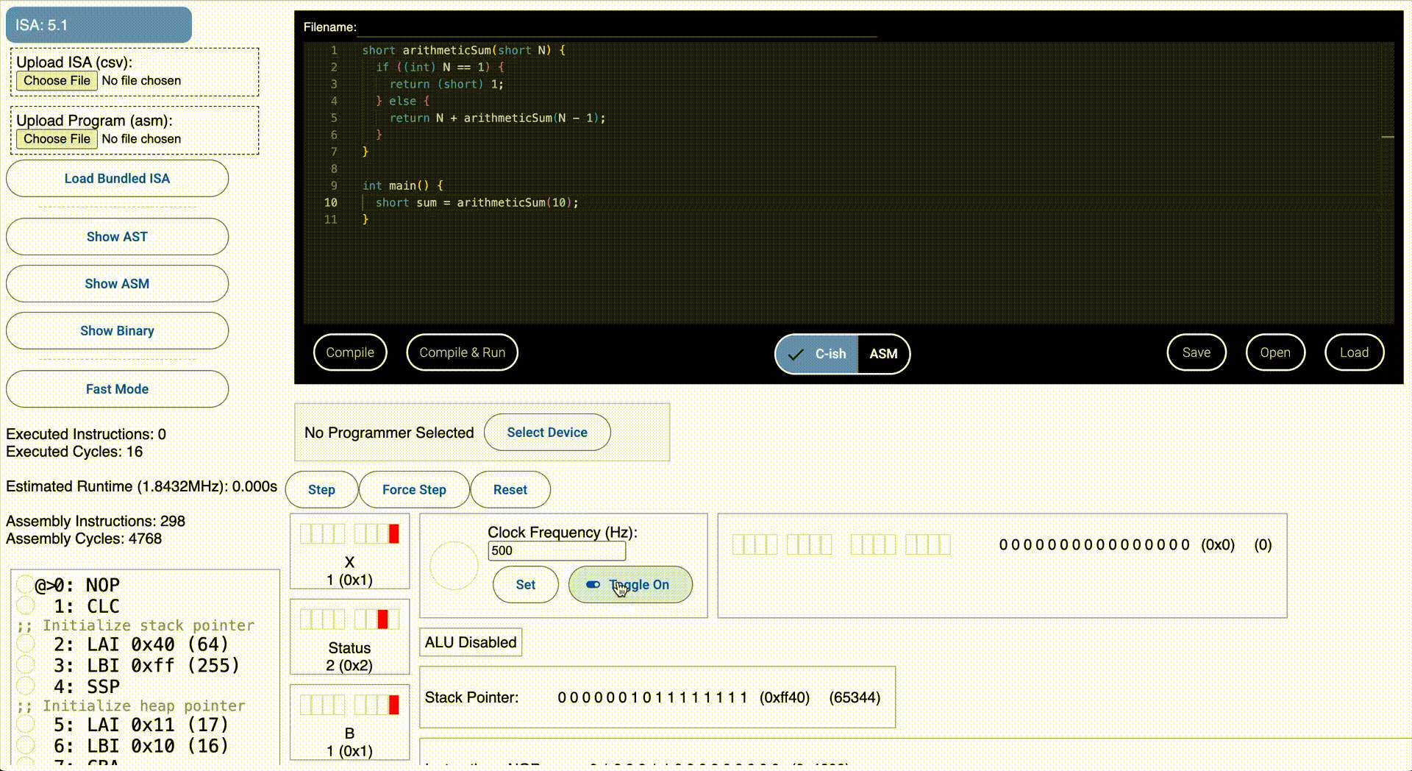
static/img/simulator/header.gif
