sarietta/theoputer-blog/static/img/transmission-line-reflections/2x/Asset 1@2x.png

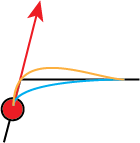
static/img/transmission-line-reflections/2x/Asset 1@2x.png
