sarietta/theoputer-blog/static/img/transmission-line-reflections/2x/momentum-simple@2x.png

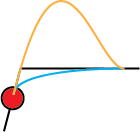
static/img/transmission-line-reflections/2x/momentum-simple@2x.png
