sarietta/theoputer-blog/static/img/transmission-line-reflections/2x/momentum@2x.png

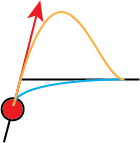
static/img/transmission-line-reflections/2x/momentum@2x.png
