sarietta/theoputer-blog/static/img/transmission-line-reflections/clock-resistors.png

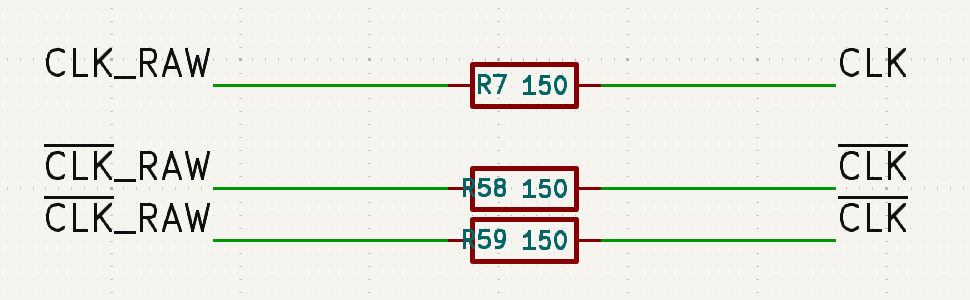
static/img/transmission-line-reflections/clock-resistors.png
