sarietta/theoputer-blog/static/img/transmission-line-reflections/clock-trace.png

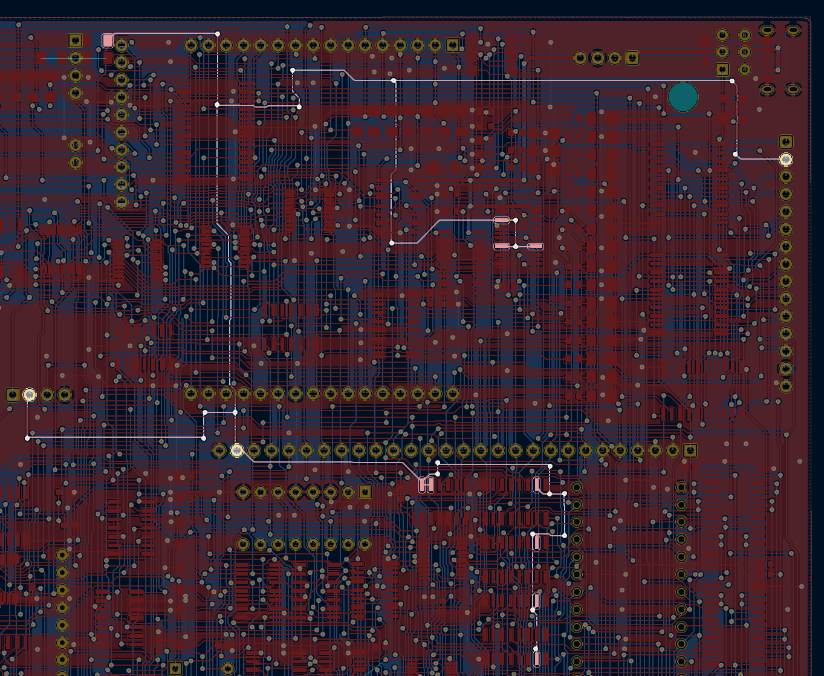
static/img/transmission-line-reflections/clock-trace.png
