sarietta/theoputer-blog/static/img/transmission-line-reflections/fourier-300-terms.png

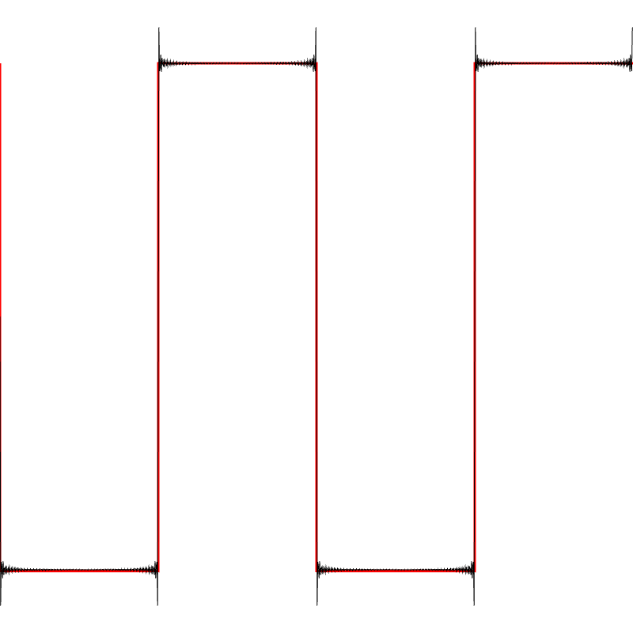
static/img/transmission-line-reflections/fourier-300-terms.png
