sarietta/theoputer-blog/static/img/transmission-line-reflections/header.png

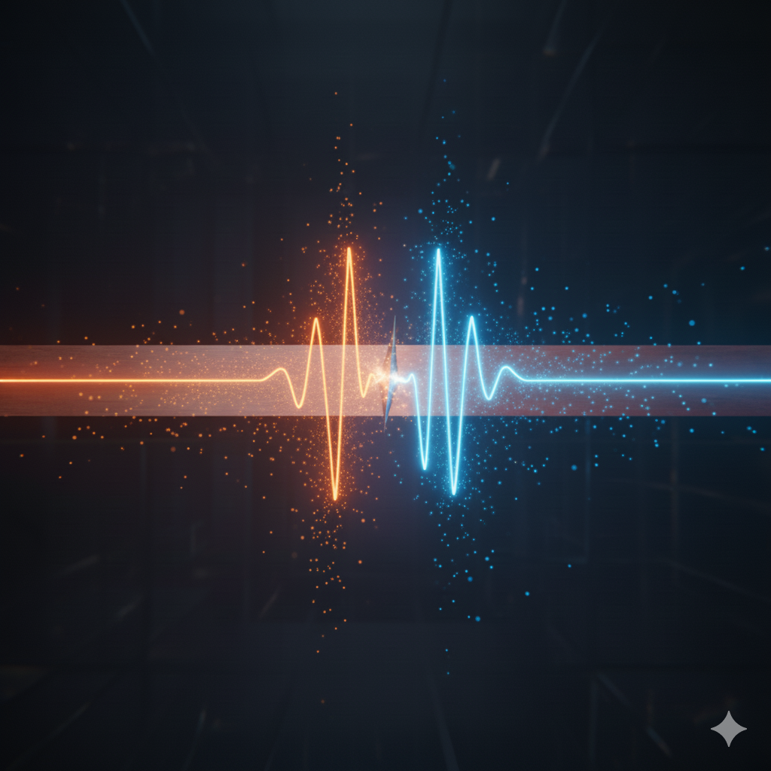
static/img/transmission-line-reflections/header.png
