sarietta/theoputer-blog/static/img/instruction-and-control/4x/simplified-parts@4x.png

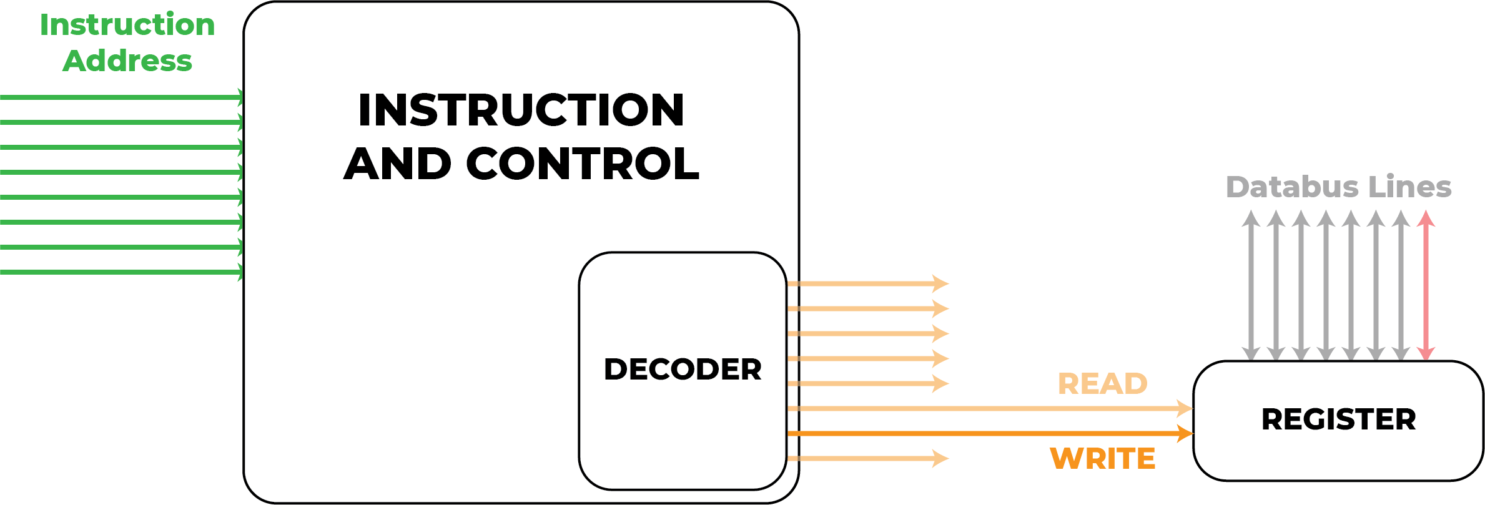
static/img/instruction-and-control/4x/simplified-parts@4x.png
