sarietta/theoputer-blog/content/posts/assembly.md

+++
title = 'Assembly'
date = 2025-10-25T20:24:05-07:00
draft = true
+++
