sarietta/theoputer-blog/content/posts/instruction-microcoder.md

+++
title = 'Instruction Microcoder'
date = 2024-10-08T11:30:30-07:00
draft = true
categories = ['Sub Systems']
tags = ['Instruction Set']
+++
