sarietta/theoputer-blog/static/img/1x/instructions.png

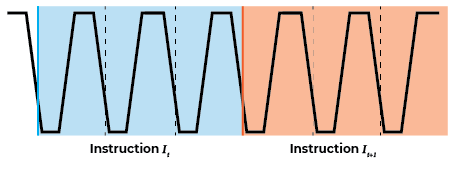
static/img/1x/instructions.png
