sarietta/theoputer-blog/static/img/1x/special-instruction.png

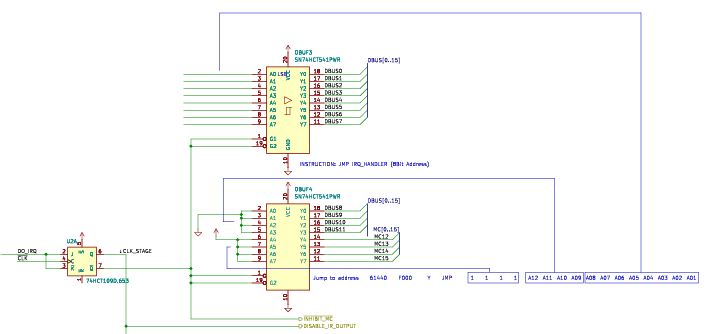
static/img/1x/special-instruction.png
