sarietta/theoputer-blog/static/img/c-compiler-intro/4x/steps@4x.png

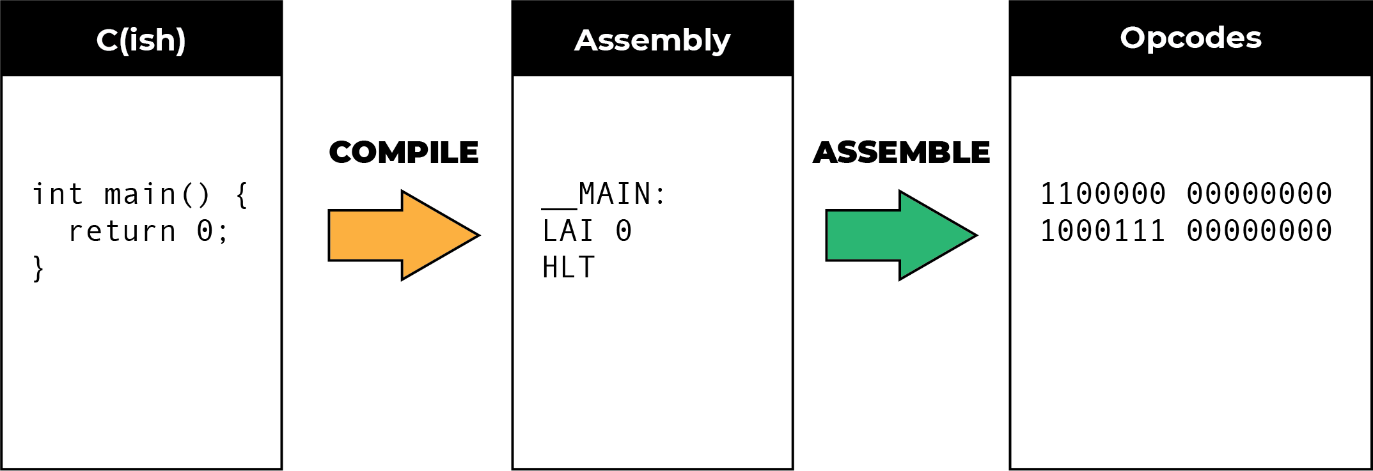
static/img/c-compiler-intro/4x/steps@4x.png
