sarietta/theoputer-blog/static/img/instruction-and-control/4x/clocked@4x.png

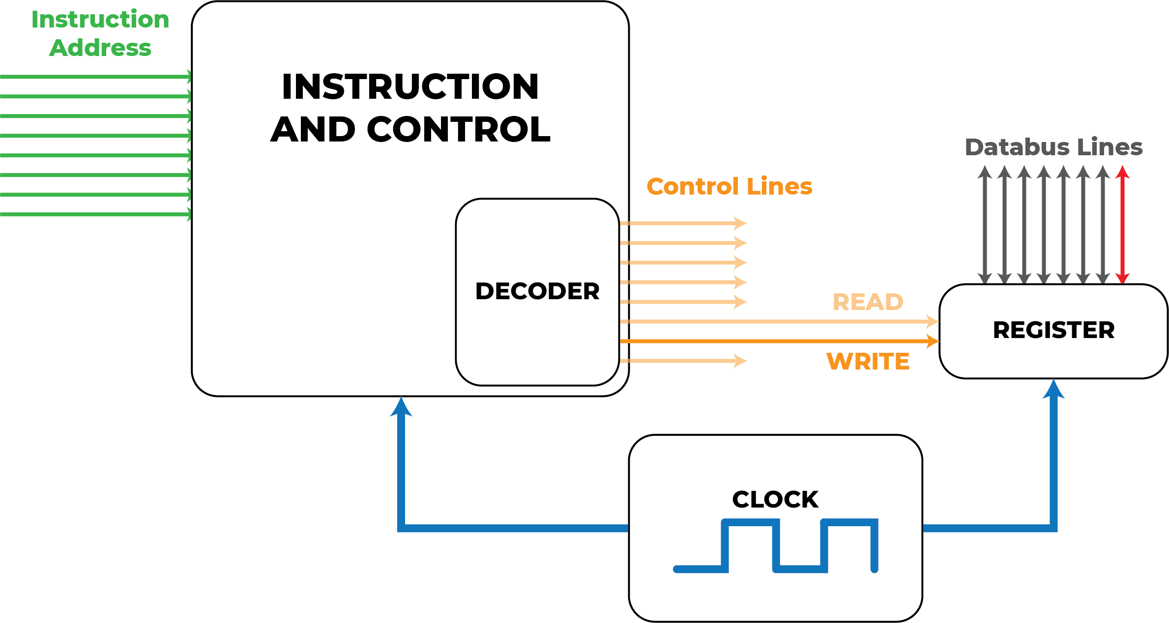
static/img/instruction-and-control/4x/clocked@4x.png
