sarietta/theoputer-blog/static/img/instruction-and-control/4x/phase-1-out@4x.png

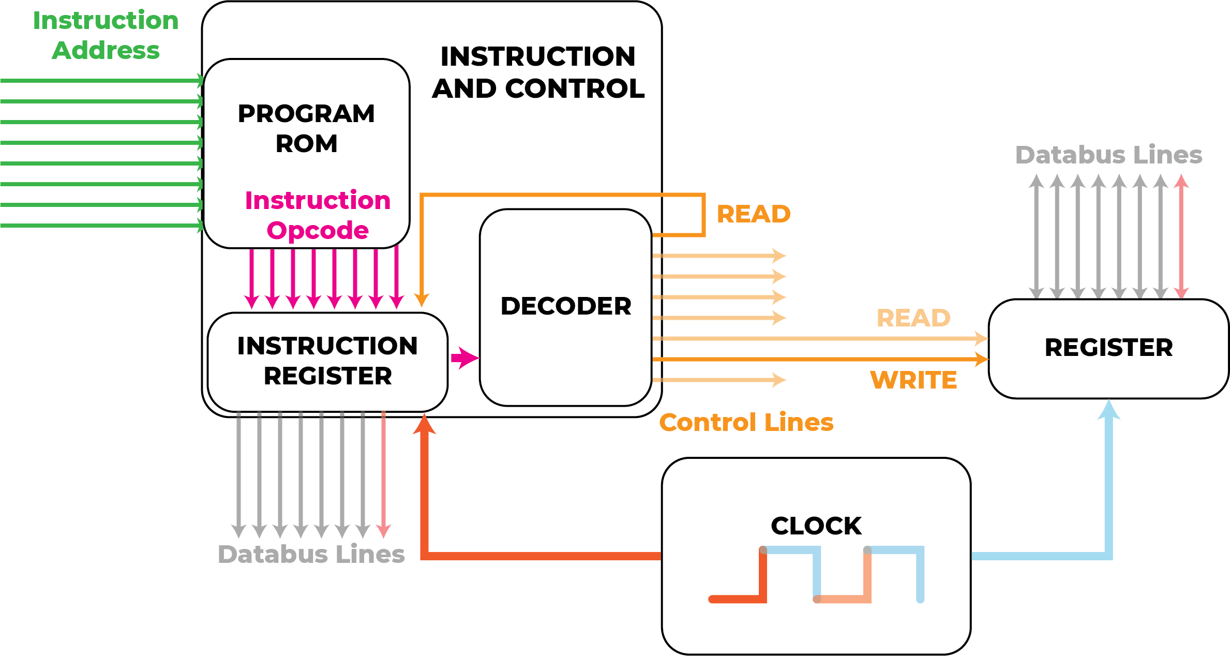
static/img/instruction-and-control/4x/phase-1-out@4x.png
