sarietta/theoputer-blog/static/img/instruction-and-control/4x/phase-2@4x.png

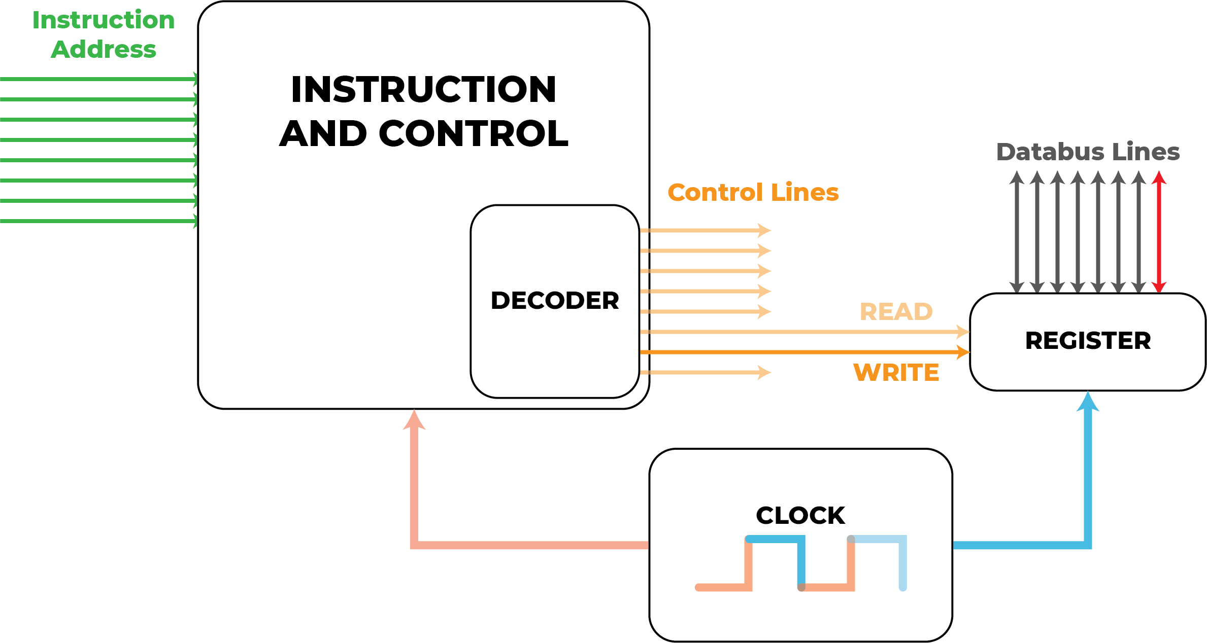
static/img/instruction-and-control/4x/phase-2@4x.png
