sarietta/theoputer-blog/static/img/instruction-and-control/4x/phases@4x.png

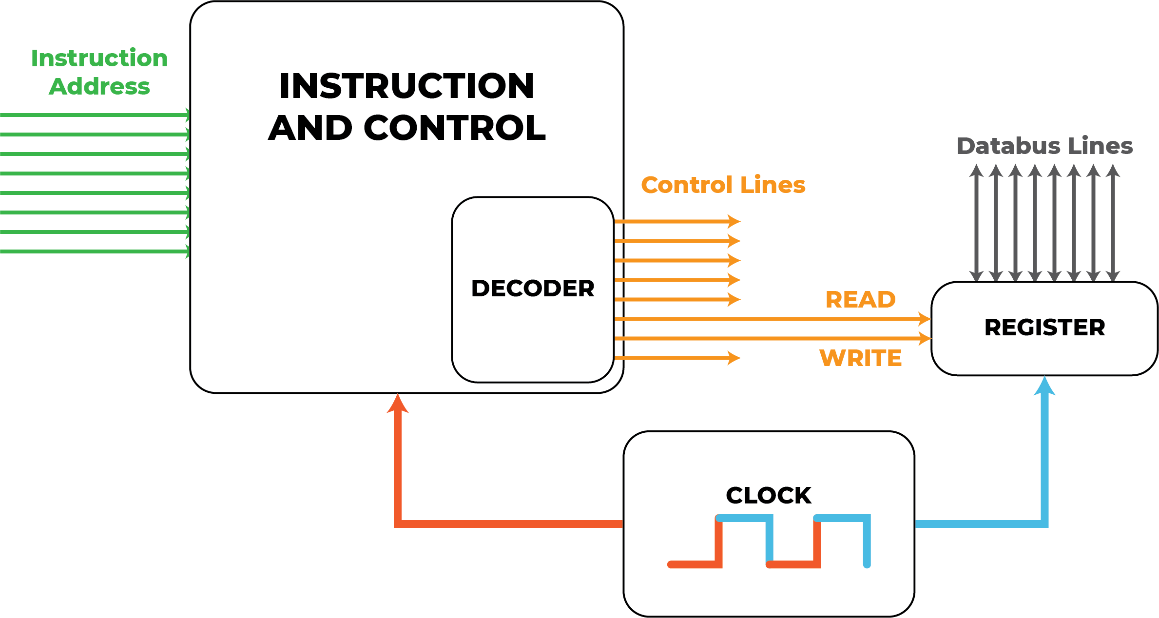
static/img/instruction-and-control/4x/phases@4x.png
