sarietta/theoputer-blog/static/img/recursion/4x/stack-operations@4x.png

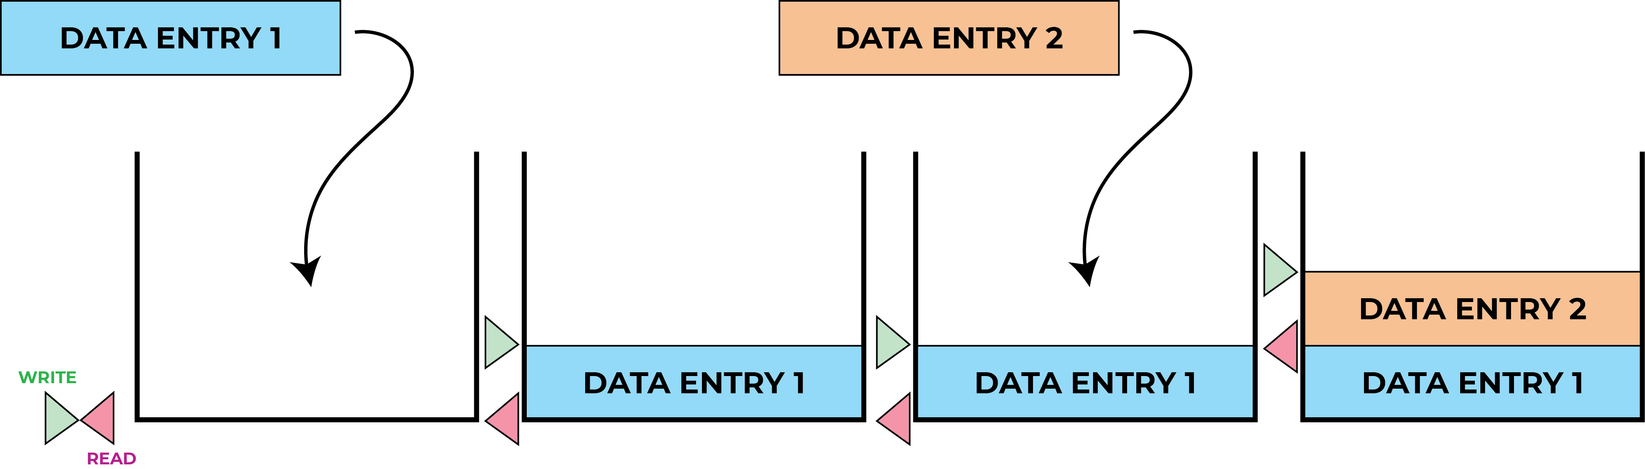
static/img/recursion/4x/stack-operations@4x.png
