sarietta/theoputer-blog/static/img/daughter-board-redesign/Daughter Assembly.V6-20251128-F_Cu.pdf

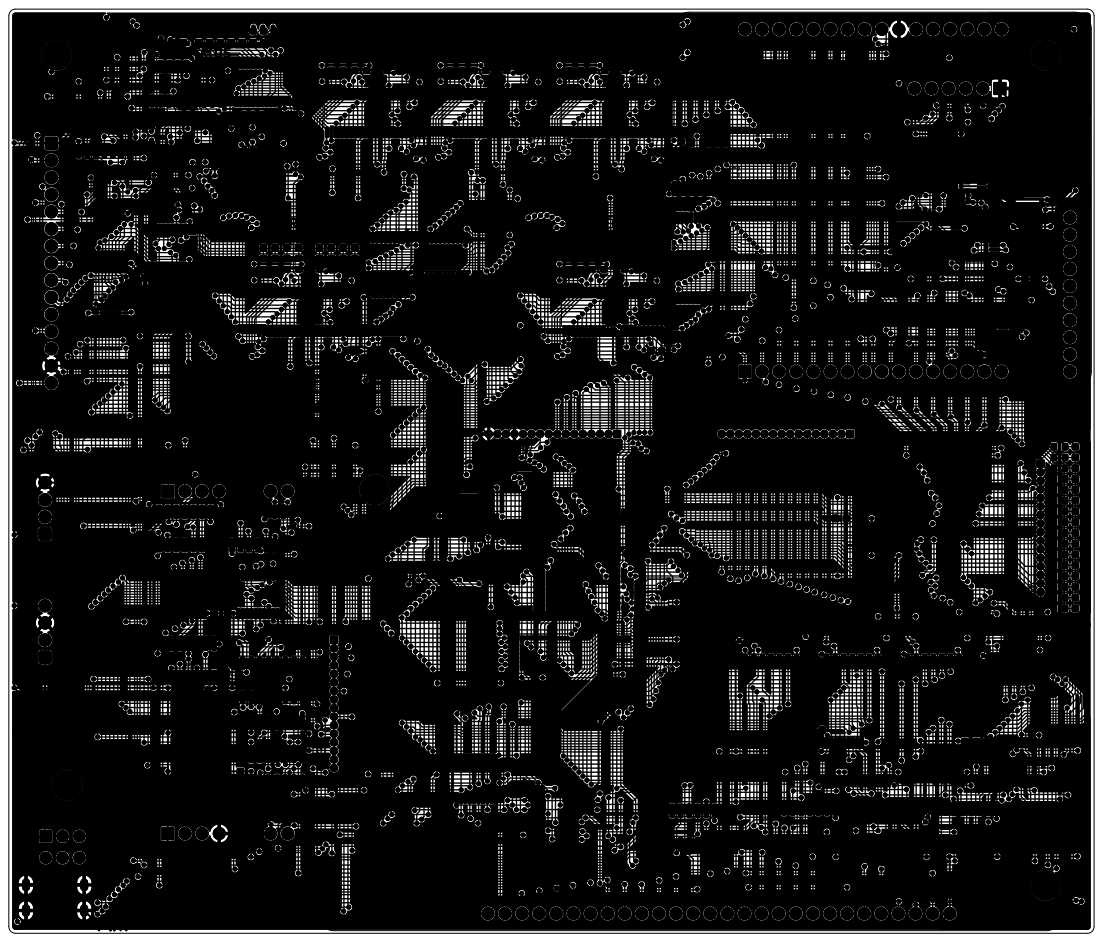
[picture p77: page 1]
