sarietta/theoputer-blog/static/pcb/Instruction and Control V8.20250912.kicad_pcb

## KiCad design static/pcb/Instruction and Control V8.20250912.kicad_pcb (2025-10-08)

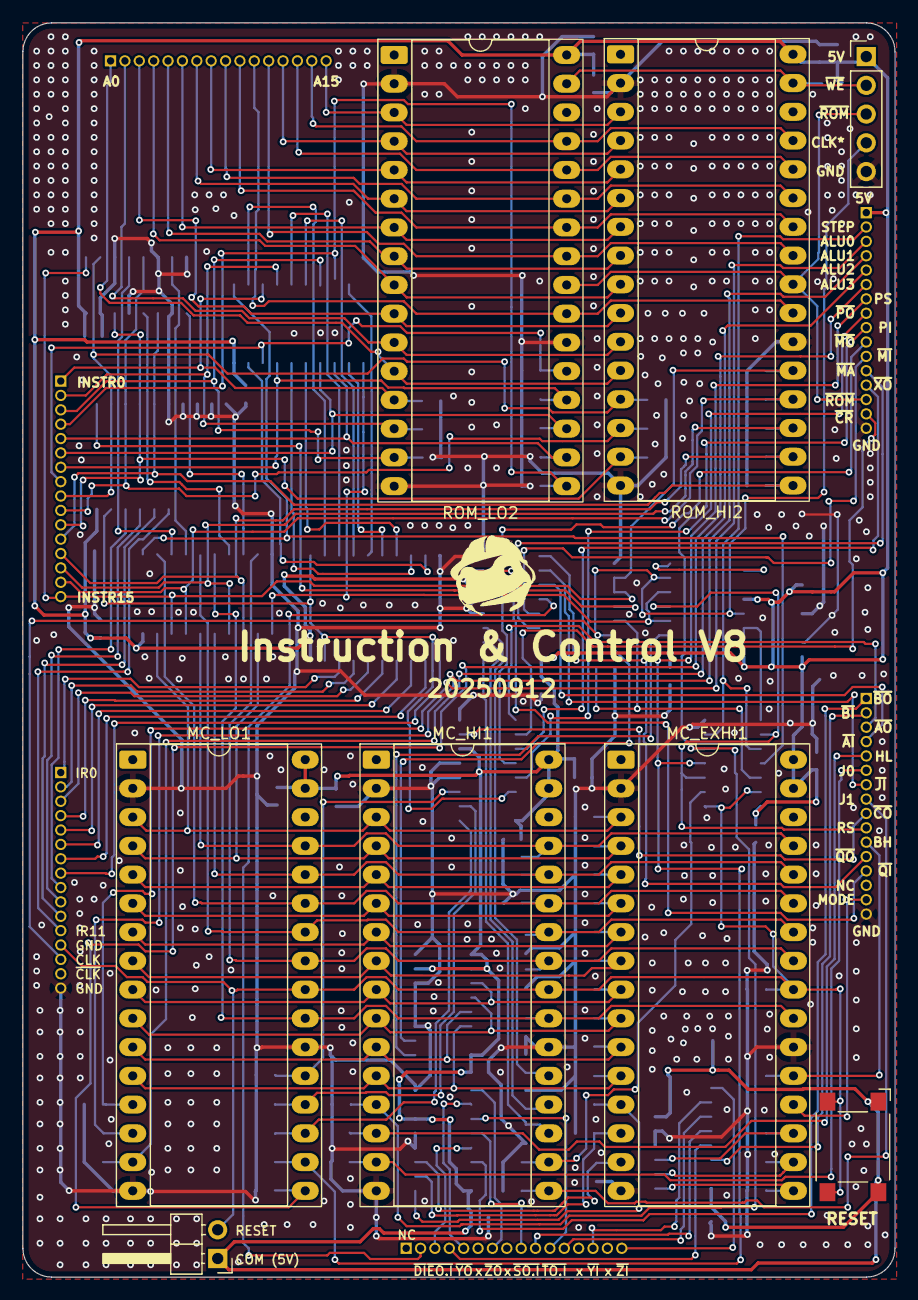
[picture p78: board Instruction and Control V8.20250912.kicad_pcb from above]

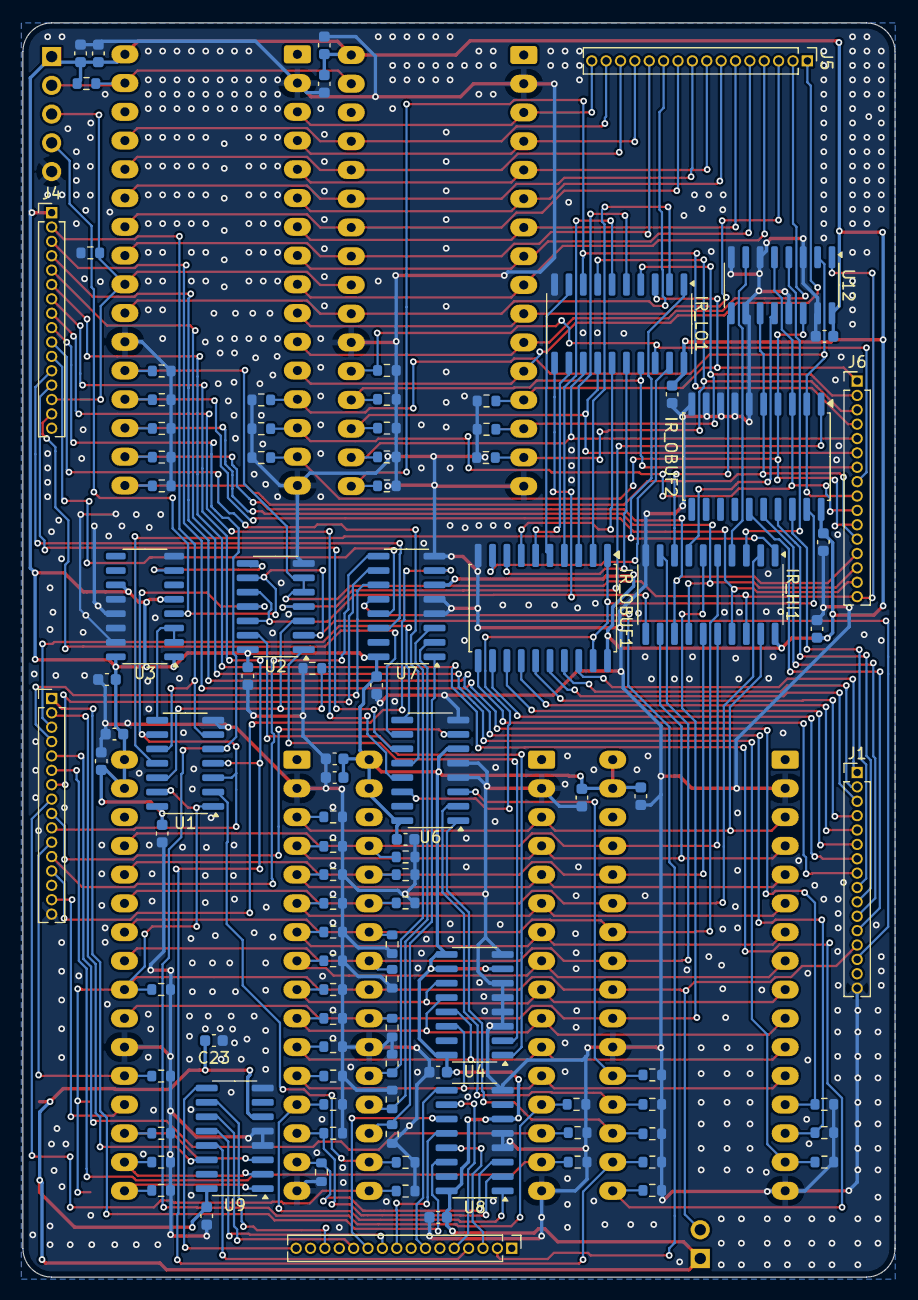
[picture p79: board Instruction and Control V8.20250912.kicad_pcb from below]

Board: 2 copper layers, 77.1 x 110.8 mm, 109 parts (101 on the bottom side), 138 nets.

Parts:
C1, C19, C20, C21, C22: 1uF; C_0603_1608Metric
C2, C3, C4, C5, C6, C7, C8, C9, C10, C11, C12, C13, C14, C15, C16, C17, C18, C23: 0.1uF; C_0603_1608Metric
IR_HI1: 74HCT374; SO-20_5.3x12.6mm_P1.27mm
IR_LO1: 74HCT374; SO-20_5.3x12.6mm_P1.27mm
IR_OBUF1, IR_OBUF2: 74HCT541D,653; SOIC-20W_7.5x12.8mm_P1.27mm
J1, J3, J4, J5, J6, J9: Conn_01x16; PinHeader_1x16_P1.27mm_Vertical
J2: Conn_01x05; PinHeader_1x05_P2.54mm_Vertical
J7: Conn_01x02; PinHeader_1x02_P2.54mm_Horizontal
MC_EXHI1: SST39SF010; DIP-32_W15.24mm_Socket_LongPads
MC_HI1: SST39SF010; DIP-32_W15.24mm_Socket_LongPads
MC_LO1: SST39SF010; DIP-32_W15.24mm_Socket_LongPads
R1, R3, R4, R5, R6, R7, R8, R9, R10, R11, R12, R13, R14, R15, R16, R17, R18, R19, R20, R21, R22, R23, R24, R25, R26, R27, R28, R29, R30, R31, R32, R33, R34, R35, R36, R37, R38, R39, R40, R41, R42, R47, R48, R49, R50, R51, R52, R53, R54, R55, R56, R57, R58, R59, R60, R61, R62, R66, R67: 1K; R_0603_1608Metric
ROM_HI2: SST39SF010; DIP-32_W15.24mm_Socket_LongPads
ROM_LO2: SST39SF010; DIP-32_W15.24mm_Socket_LongPads
SW1: SW_Omron_B3FS; SW_SPST_Omron_B3FS-100xP
U1: SN74ACT32DR; SOIC-14_3.9x8.7mm_P1.27mm
U2: SN74HCT02DR; SOIC-14_3.9x8.7mm_P1.27mm
U3: 74HC109D,653; SO-16_3.9x9.9mm_P1.27mm
U4: 74ACT161; SOIC-16_3.9x9.9mm_P1.27mm
U6, U7, U8, U9: SN74HCT138DR; SOIC-16_3.9x9.9mm_P1.27mm
U12: SN74HC257DR; SOIC-16_3.9x9.9mm_P1.27mm

Connections:
+5V: C1.1, C2.1, C3.1, C4.1, C5.1, C6.1, C7.1, C8.1, C9.1, C10.1, C11.1, C12.1, C13.1, C14.1, C15.1, C16.1, C17.1, C18.1, C19.1, C20.1, C21.1, C22.1, C23.1, IR_HI1.20 (VCC), IR_LO1.20 (VCC), IR_OBUF1.20 (VCC), IR_OBUF2.20 (VCC), J2.1, J4.1, J7.1, MC_EXHI1.31 (PGM), MC_EXHI1.32 (VCC), MC_HI1.31 (PGM), MC_HI1.32 (VCC), MC_LO1.31 (PGM), MC_LO1.32 (VCC), R66.2, ROM_HI2.32 (VCC), ROM_LO2.32 (VCC), SW1.1, U1.14 (VCC), U2.14 (VCC), U3.1 (~R), U3.5 (~S), U3.11 (~S), U3.16 (VCC), U4.7 (CEP), U4.9 (~PE), U4.10 (CET), U4.16 (VCC), U6.6 (E2), U6.16 (VCC), U7.6 (E2), U7.16 (VCC), U8.6 (E2), U8.16 (VCC), U9.6 (E2), U9.16 (VCC), U12.16 (VCC)
/ADDR0: J5.1, ROM_HI2.12 (A0), ROM_LO2.12 (A0)
/ADDR1: J5.2, ROM_HI2.11 (A1), ROM_LO2.11 (A1)
/ADDR2: J5.3, ROM_HI2.10 (A2), ROM_LO2.10 (A2)
/ADDR3: J5.4, ROM_HI2.9 (A3), ROM_LO2.9 (A3)
/ADDR4: J5.5, ROM_HI2.8 (A4), ROM_LO2.8 (A4)
/ADDR5: J5.6, ROM_HI2.7 (A5), ROM_LO2.7 (A5)
/ADDR6: J5.7, ROM_HI2.6 (A6), ROM_LO2.6 (A6)
/ADDR7: J5.8, ROM_HI2.5 (A7), ROM_LO2.5 (A7)
/ADDR8: J5.9, ROM_HI2.27 (A8), ROM_LO2.27 (A8)
/ADDR9: J5.10, ROM_HI2.26 (A9), ROM_LO2.26 (A9)
/ADDR10: J5.11, ROM_HI2.23 (A10), ROM_LO2.23 (A10)
/ADDR11: J5.12, ROM_HI2.25 (A11), ROM_LO2.25 (A11)
/ADDR12: J5.13, ROM_HI2.4 (A12), ROM_LO2.4 (A12)
/ADDR13: J5.14, ROM_HI2.28 (A13), ROM_LO2.28 (A13)
/ADDR14: J5.15, ROM_HI2.29 (A14), ROM_LO2.29 (A14)
/ADDR15: J5.16, ROM_HI2.3 (A15), ROM_LO2.3 (A15)
/ALU0: J4.3, MC_LO1.13 (D0), R38.1
/ALU1: J4.4, MC_LO1.14 (D1), R36.1
/ALU2: J4.5, MC_LO1.15 (D2), R34.1
/ALU3: J4.6, MC_LO1.17 (D3), R33.1
/BO_HI: J3.11, MC_EXHI1.21 (D7), R32.1
/CLK: J1.14, J2.4, U2.2, U2.9, U3.4 (C)
/DISABLE_ROM: J2.3, J4.14, R67.2, ROM_HI2.24 (OE), ROM_LO2.24 (OE)
/EXEC_MODE: J3.15, MC_EXHI1.20 (D6)
/EXT_IN0: MC_EXHI1.17 (D3), R39.1, U9.1 (A0)
/EXT_IN1: MC_EXHI1.18 (D4), R37.1, U9.2 (A1)
/EXT_IN2: MC_EXHI1.19 (D5), R35.1, U9.3 (A2)
/EXT_OUT0: MC_EXHI1.13 (D0), R42.1, U8.1 (A0)
/EXT_OUT1: MC_EXHI1.14 (D1), R41.1, U8.2 (A1)
/EXT_OUT2: MC_EXHI1.15 (D2), R40.1, U8.3 (A2)
/HL: J3.5, MC_HI1.14 (D1), R26.1
/IN0: MC_HI1.19 (D5), R22.1, U7.1 (A0)
/IN1: MC_HI1.20 (D6), R21.1, U7.2 (A1)
/IN2: MC_HI1.21 (D7), R20.1, U7.3 (A2)
/INHIBIT_MC: R1.1, U1.12, U2.3
/INSTR0: IR_LO1.3 (D0), J6.1, R62.1, ROM_LO2.13 (D0)
/INSTR1: IR_LO1.4 (D1), J6.2, R61.1, ROM_LO2.14 (D1)
/INSTR2: IR_LO1.7 (D2), J6.3, R60.1, ROM_LO2.15 (D2)
/INSTR3: IR_LO1.8 (D3), J6.4, R59.1, ROM_LO2.17 (D3)
/INSTR4: IR_LO1.13 (D4), J6.5, R58.1, ROM_LO2.18 (D4)
/INSTR5: IR_LO1.14 (D5), J6.6, R57.1, ROM_LO2.19 (D5)
/INSTR6: IR_LO1.17 (D6), J6.7, R56.1, ROM_LO2.20 (D6)
/INSTR7: IR_LO1.18 (D7), J6.8, R55.1, ROM_LO2.21 (D7)
/INSTR8: IR_OBUF2.2 (A0), J6.9, R54.1, ROM_HI2.13 (D0), U12.2 (I0a)
/INSTR9: IR_OBUF2.3 (A1), J6.10, R53.1, ROM_HI2.14 (D1), U12.5 (I0b)
/INSTR10: IR_OBUF2.4 (A2), J6.11, R52.1, ROM_HI2.15 (D2), U12.14 (I0c)
/INSTR11: IR_OBUF2.5 (A3), J6.12, R51.1, ROM_HI2.17 (D3), U12.11 (I0d)
/INSTR12: IR_HI1.13 (D4), J6.13, R50.1, ROM_HI2.18 (D4)
/INSTR13: IR_HI1.14 (D5), J6.14, R49.1, ROM_HI2.19 (D5)
/INSTR14: IR_HI1.17 (D6), J6.15, R48.1, ROM_HI2.20 (D6)
/INSTR15: IR_HI1.18 (D7), J6.16, R47.1, ROM_HI2.21 (D7), U2.5, U2.6, U12.1 (S)
/IR_OUT0: IR_OBUF1.18 (Y0), J1.1
/IR_OUT1: IR_OBUF1.17 (Y1), J1.2
/IR_OUT2: IR_OBUF1.16 (Y2), J1.3
/IR_OUT3: IR_OBUF1.15 (Y3), J1.4
/IR_OUT4: IR_OBUF1.14 (Y4), J1.5
/IR_OUT5: IR_OBUF1.13 (Y5), J1.6
/IR_OUT6: IR_OBUF1.12 (Y6), J1.7
/IR_OUT7: IR_OBUF1.11 (Y7), J1.8
/IR_OUT8: IR_OBUF2.18 (Y0), J1.9
/IR_OUT9: IR_OBUF2.17 (Y1), J1.10
/IR_OUT10: IR_OBUF2.16 (Y2), J1.11
/IR_OUT11: IR_OBUF2.15 (Y3), J1.12
/J0: J3.6, MC_HI1.15 (D2), R25.1
/J1: J3.8, MC_HI1.17 (D3), R24.1
/MC0: MC_EXHI1.12 (A0), MC_HI1.12 (A0), MC_LO1.12 (A0), R19.1, U4.14 (Q0)
/MC1: MC_EXHI1.11 (A1), MC_HI1.11 (A1), MC_LO1.11 (A1), R18.1, U4.13 (Q1)
/MC2: MC_EXHI1.10 (A2), MC_HI1.10 (A2), MC_LO1.10 (A2), R17.1, U4.12 (Q2)
/MC3: MC_EXHI1.9 (A3), MC_HI1.9 (A3), MC_LO1.9 (A3), R16.1, U4.11 (Q3)
/MC4: MC_EXHI1.8 (A4), MC_HI1.8 (A4), MC_LO1.8 (A4), R15.1
/MC5: MC_EXHI1.7 (A5), MC_HI1.7 (A5), MC_LO1.7 (A5), R14.1
/MC6: MC_EXHI1.6 (A6), MC_HI1.6 (A6), MC_LO1.6 (A6), R13.1
/MC7: MC_EXHI1.5 (A7), MC_HI1.5 (A7), MC_LO1.5 (A7), R12.1
/MC8: IR_HI1.2 (O0), MC_EXHI1.27 (A8), MC_HI1.27 (A8), MC_LO1.27 (A8), R11.1
/MC9: IR_HI1.5 (O1), MC_EXHI1.26 (A9), MC_HI1.26 (A9), MC_LO1.26 (A9), R10.1
/MC10: IR_HI1.6 (O2), MC_EXHI1.23 (A10), MC_HI1.23 (A10), MC_LO1.23 (A10), R9.1
/MC11: IR_HI1.9 (O3), MC_EXHI1.25 (A11), MC_HI1.25 (A11), MC_LO1.25 (A11), R8.1
/MC12: IR_HI1.12 (O4), MC_EXHI1.4 (A12), MC_HI1.4 (A12), MC_LO1.4 (A12), R7.1
/MC13: IR_HI1.15 (O5), MC_EXHI1.28 (A13), MC_HI1.28 (A13), MC_LO1.28 (A13), R6.1
/MC14: IR_HI1.16 (O6), MC_EXHI1.29 (A14), MC_HI1.29 (A14), MC_LO1.29 (A14), R5.1
/MC15: IR_HI1.19 (O7), MC_EXHI1.3 (A15), MC_HI1.3 (A15), MC_LO1.3 (A15), R4.1
/OUT0: MC_LO1.19 (D5), R30.1, U6.1 (A0)
/OUT1: MC_LO1.20 (D6), R29.1, U6.2 (A1)
/OUT2: MC_LO1.21 (D7), R28.1, U6.3 (A2)
/PI: J4.9, MC_HI1.13 (D0), R27.1, U1.5
/PS: J4.7, MC_LO1.18 (D4), R31.1, U1.4
/RS: J3.10, U1.3, U1.9, U2.11
/RS1^{*}: MC_HI1.18 (D4), R23.1, U1.2
/RS2^{*}: J1.13, J7.2, MC_EXHI1.24 (OE), MC_HI1.24 (OE), MC_LO1.24 (OE), R3.2, SW1.2, U1.1, U1.13
/STEP: J4.2, U1.6, U1.10
/~AI: J3.4, U7.11 (~Y4)
/~AO: J3.3, U6.9 (~Y6)
/~BI: J3.2, U9.14 (~Y1)
/~BO: J3.1, U8.14 (~Y1)
/~CO: J3.9, U6.7 (~Y7)
/~CR: J4.15, U6.10 (~Y5)
/~DI: J9.2, U7.12 (~Y3)
/~EI: J9.4, U9.13 (~Y2)
/~EO: J9.3, U8.13 (~Y2)
/~IO: IR_OBUF1.1 (G1), IR_OBUF1.19 (G2), IR_OBUF2.19 (G2), U6.14 (~Y1)
/~JI: J3.7, U7.10 (~Y5)
/~MA: J4.12, U7.14 (~Y1)
/~MI: J4.11, U7.13 (~Y2)
/~MO: J4.10, U6.12 (~Y3)
/~PO: J4.8, U6.13 (~Y2)
/~QI: J3.13, U7.7 (~Y7)
/~QO: J3.12, U7.9 (~Y6)
/~RESET_MC_COUNTER_NEXT_DOWNCLK: U2.8, U3.7 (~Q)
/~RESET_MC_COUNTER: U2.13, U4.1 (~MR)
/~ROM_WE: J2.2, R66.1, ROM_HI2.31 (PGM), ROM_LO2.31 (PGM)
/~SI: J9.10, U9.12 (~Y3)
/~SO: J9.9, U8.12 (~Y3)
/~TI: J9.12, U9.11 (~Y4)
/~TO: J9.11, U8.11 (~Y4)
/~XO: J4.13, U6.11 (~Y4)
/~YI: J9.14, U9.10 (~Y5)
/~YO: J9.5, U8.10 (~Y5)
/~ZI: J9.16, U9.9 (~Y6)
/~ZO: J9.7, U8.9 (~Y6)
/↓LATCH_INSTRUCTION: IR_HI1.11 (Cp), IR_LO1.11 (Cp), U2.10, U2.12
GND: C1.2, C2.2, C3.2, C4.2, C5.2, C6.2, C7.2, C8.2, C9.2, C10.2, C11.2, C12.2, C13.2, C14.2, C15.2, C16.2, C17.2, C18.2, C19.2, C20.2, C21.2, C22.2, C23.2, IR_HI1.10 (GND), IR_LO1.10 (GND), IR_OBUF1.10 (GND), IR_OBUF2.6 (A4), IR_OBUF2.7 (A5), IR_OBUF2.8 (A6), IR_OBUF2.9 (A7), IR_OBUF2.10 (GND), J1.16, J2.5, J3.16, J4.16, MC_EXHI1.2 (A16), MC_EXHI1.16 (GND), MC_EXHI1.22 (CE), MC_HI1.2 (A16), MC_HI1.16 (GND), MC_HI1.22 (CE), MC_LO1.2 (A16), MC_LO1.16 (GND), MC_LO1.22 (CE), R1.2, R3.1, R4.2, R5.2, R6.2, R7.2, R8.2, R9.2, R10.2, R11.2, R12.2, R13.2, R14.2, R15.2, R16.2, R17.2, R18.2, R19.2, R20.2, R21.2, R22.2, R23.2, R24.2, R25.2, R26.2, R27.2, R28.2, R29.2, R30.2, R31.2, R32.2, R33.2, R34.2, R35.2, R36.2, R37.2, R38.2, R39.2, R40.2, R41.2, R42.2, R47.2, R48.2, R49.2, R50.2, R51.2, R52.2, R53.2, R54.2, R55.2, R56.2, R57.2, R58.2, R59.2, R60.2, R61.2, R62.2, R67.1, ROM_HI2.2 (A16), ROM_HI2.16 (GND), ROM_HI2.22 (CE), ROM_LO2.2 (A16), ROM_LO2.16 (GND), ROM_LO2.22 (CE), U1.7 (GND), U2.7 (GND), U3.8 (GND), U3.12 (C), U3.13 (~K), U3.14 (J), U3.15 (~R), U4.3 (D0), U4.4 (D1), U4.5 (D2), U4.6 (D3), U4.8 (GND), U6.4 (~E0), U6.5 (~E1), U6.8 (GND), U7.4 (~E0), U7.5 (~E1), U7.8 (GND), U8.4 (~E0), U8.5 (~E1), U8.8 (GND), U9.4 (~E0), U9.5 (~E1), U9.8 (GND), U12.3 (I1a), U12.6 (I1b), U12.8 (GND), U12.10 (I1d), U12.13 (I1c), U12.15 (OE)
unnamed: IR_HI1.3 (D0), U12.4 (Za)
unnamed: IR_HI1.4 (D1), U12.7 (Zb)
unnamed: IR_HI1.7 (D2), U12.12 (Zc)
unnamed: IR_HI1.8 (D3), U12.9 (Zd)
unnamed: IR_HI1.1 (OE), IR_LO1.1 (OE), U1.11
unnamed: IR_LO1.2 (O0), IR_OBUF1.2 (A0)
unnamed: IR_LO1.5 (O1), IR_OBUF1.3 (A1)
unnamed: IR_LO1.6 (O2), IR_OBUF1.4 (A2)
unnamed: IR_LO1.9 (O3), IR_OBUF1.5 (A3)
unnamed: IR_LO1.12 (O4), IR_OBUF1.6 (A4)
unnamed: IR_LO1.15 (O5), IR_OBUF1.7 (A5)
unnamed: IR_LO1.16 (O6), IR_OBUF1.8 (A6)
unnamed: IR_LO1.19 (O7), IR_OBUF1.9 (A7)
unnamed: IR_OBUF2.1 (G1), U2.4
unnamed: U1.8, U3.2 (J), U3.3 (~K)
unnamed: U2.1, U4.2 (CP)
