sarietta/theoputer-blog/static/pcb/Clock.V6-20250408.kicad_pcb

## KiCad design static/pcb/Clock.V6-20250408.kicad_pcb (2025-09-29)

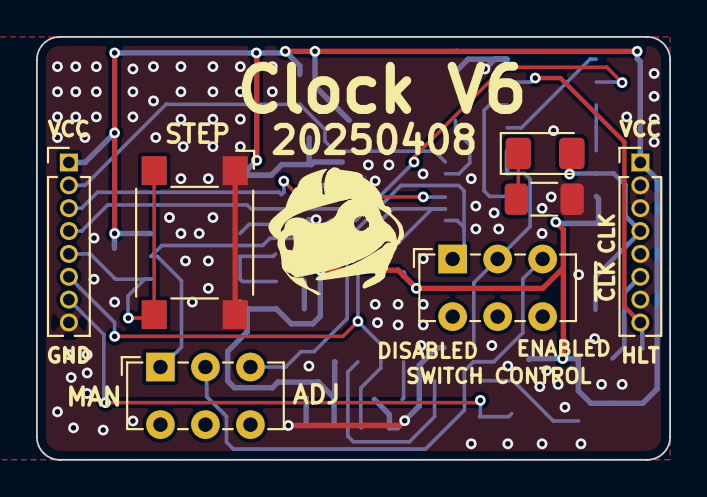
[picture p80: board Clock.V6-20250408.kicad_pcb from above]

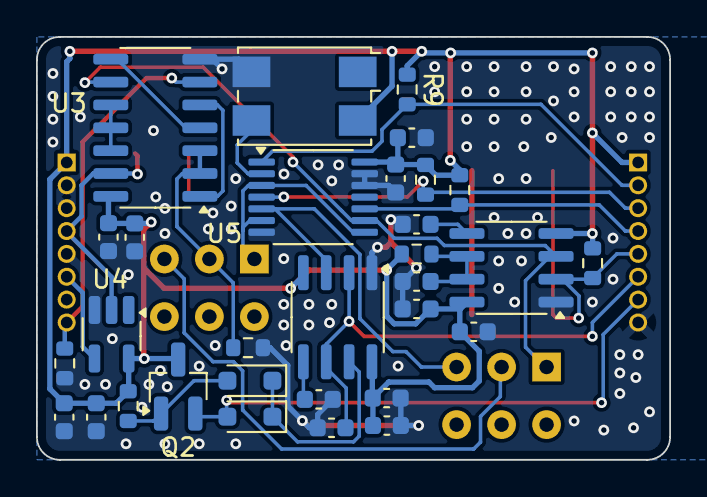
[picture p81: board Clock.V6-20250408.kicad_pcb from below]

Board: 4 copper layers, 35.2 x 23.5 mm, 38 parts (31 on the bottom side), 26 nets.

Parts:
C1, C2, C5, C10, C12, C14: 1uF; C_0603_1608Metric
C3, C6: 0.01uF; C_0603_1608Metric
C4, C9, C11, C13, C15: 0.1uF; C_0603_1608Metric
C7: 22uF; C_0603_1608Metric
D1, D2: 1N5819WS; D_SOD-323_HandSoldering
D3: LED; LED_1206_3216Metric_Pad1.42x1.75mm_HandSolder
J7, J8: Conn_01x08; PinHeader_1x08_P1.27mm_Vertical
Q2: MMBT3904; SOT-23_Handsoldering
R1, R5, R6, R7, R8, R9: 1K; R_0603_1608Metric
R2, R3: 10K; R_0603_1608Metric
R4: 1K; R_1206_3216Metric_Pad1.30x1.75mm_HandSolder
SW_EN1: SW_SPDT; SW_E-Switch_EG1271_SPDT
SW_MAN_OR_ADJ1: SW_SPDT; SW_E-Switch_EG1271_SPDT
SW_STEP_1: SW_Omron_B3FS; SW_SPST_Omron_B3FS-100xP
U1, U2: TLC555xD; SOIC-8_3.9x4.9mm_P1.27mm
U3: SN74HCT02DR; SOIC-14_3.9x8.7mm_P1.27mm
U4: SN74AHCT1G04DBVR; SOT-23-5_HandSoldering
U5: SN74AHCT125PWR; TSSOP-14_4.4x5mm_P0.65mm
X1: S7D1.843200A20F30T; Crystal_SMD_7050-4Pin_7.0x5.0mm

Connections:
+5V: C1.1, C4.1, C5.1, C9.1, C10.1, C11.1, C12.1, C13.1, C14.1, C15.1, J7.1, J8.1, Q2.3 (C), R1.1, R2.1, R3.1, R6.1, R8.1, R9.1, U1.4 (R), U1.8 (VCC), U2.4 (R), U2.8 (VCC), U3.14 (VCC), U4.5 (VCC), U5.14 (VCC), X1.4 (VCC)
/ADJ_GND: C2.1, J7.6, U1.2 (TR), U1.6 (THR)
/ADJ_VCC: D2.2 (A), J7.7, Q2.2 (E)
/CLK: D3.2 (A), J8.4, U3.13, U4.2
/HLT: J8.8, R5.1, U3.6
/MODE_ADJUSTABLE: SW_MAN_OR_ADJ1.3 (C), U1.3 (Q), U5.5
/MODE_COM: R7.1, SW_EN1.2 (B), U3.2, U3.3
/MODE_MANUAL: SW_MAN_OR_ADJ1.1 (A), U2.3 (Q), U3.9, U5.9
/MODE_OSCILLATOR: U5.2, X1.3 (OUT)
/~CLK: J8.6, U4.4
/~MODE_ADJUSTABLE_EN: J7.3, R8.2, U5.4
/~MODE_MANUAL_EN: J7.4, R6.2, U5.10
/~MODE_OSCILLATOR_EN: J7.2, R9.2, U5.1
/~STEP_EN: J7.5, R3.2, SW_STEP_1.2, U2.2 (TR)
GND: C1.2, C2.2, C3.2, C4.2, C5.2, C6.2, C7.2, C9.2, C10.2, C11.2, C12.2, C13.2, C14.2, C15.2, J7.8, J8.2, J8.3, J8.5, J8.7, R4.2, R5.2, R7.2, SW_STEP_1.1, U1.1 (GND), U2.1 (GND), U3.7 (GND), U4.3 (GND), U5.7 (GND), U5.12, U5.13, X1.2 (GND)
unnamed: D1.2 (A), Q2.1 (B), R1.2
unnamed: D1.1 (K), D2.1 (K), U1.7 (DIS)
unnamed: D3.1 (K), R4.1
unnamed: SW_EN1.1 (A), U5.3, U5.6, U5.8
unnamed: SW_EN1.3 (C), SW_MAN_OR_ADJ1.2 (B)
unnamed: C3.1, U1.5 (CV)
unnamed: C6.1, U2.5 (CV)
unnamed: C7.1, R2.2, U2.6 (THR), U2.7 (DIS)
unnamed: U3.1, U3.5
unnamed: U3.4, U3.8
unnamed: U3.10, U3.11, U3.12
