sarietta/theoputer-blog/(commit log)

2025-09-26 Working on clock 4 layer post
    [Clock.V6-20250408.kicad_pcb]
2025-09-28 New post about ground bounce
2025-09-29 Finishing up ground noise
2025-10-08 Mooar post content. Daughter board and simulator info
2025-10-08 Static files
    [ISA-V5.1.csv, Instruction and Control V8.20250912.kicad_pcb]
2025-10-11 Improvements to the kicad viewer and the svg viewer
2025-10-11 Working on the daughter board post still
2025-10-12 Finished daughter board post
2025-10-13 Better circuitjs support from a local app. Also some new content on registers
    [amp-diff.txt, diff.txt]
2025-10-17 Improvements to the circuit web component to lazily load the project files
2025-10-26 Working on the I&C board post, but also adding in some empty content to help keep track of what I need to write
2025-11-04 New post sfor the instruction and control board, plus a lot of grammar and spelling fixes
2025-11-11 Description for the assembler post
